JumpyTruck/WRO-FE-2026-Sin-Theta/README.md

# WRO-FE-2026-Sinθ 

## Introduction

Hello! We are **Team Sin Theta**, competing in the WRO Future Engineers 2026 Challenge, bringing together three years of combined robotics experience from previous competition teams. This year, we've unified our expertise to design a high-precision autonomous robot that prioritizes **consistency, reliability, and engineering rigor**. We previously competed under two teams, The Robertos[aka AA Batteries] (Aarav) and VHR Motors (Harshad, Rajas)

**Team The Robertos Github (AA Batteries):** https://github.com/Abdu1Hak/WRO-2025

**Team VHR Github:** https://github.com/RAJAS2025/VHR-WRO-FE-June-2025

This repository contains everything needed to understand, build, and improve upon our design: 3D CAD files, full electrical schematics, detailed assembly instructions, and our complete engineering journal documenting trade-offs and lessons learned.

---

## Design Philosophy

Our design philosophy was to maximize consistency rather than peak speed. Throughout development we prioritized repeatable autonomous behaviour, resulting in a camera-based robot with Ackermann steering, a split Raspberry Pi–Arduino architecture, and a documented engineering process supported by quantitative testing, design iterations, and failure analysis. By striving to maximize overall efficiency, our resultant robot operates at the peak of robotic capability in both design and programming.

---

## The Team

<table>
  <tr>
    <td align="center">
      Canada
    </td>
    <td align="center">
      Comp
    </td>
  </tr>
  <tr>
    <td align="center">
      teamphotomain
    </td>
    <td align="center">
      
    </td>
  </tr>
</table>

<b>Aarav Daudia:</b> Hello Judges, my name is Aarav, and I am a grade 12 student with a passion for creating things that blend engineering, technology, and design. Whether I am modeling mechanical parts in CAD, programming robots, wiring electronics, or building websites and machine learning tools, I am drawn to projects that turn curiosity into something real and useful This is my second year competing in WRO FE, with my previous robotics experience coming in WRO FE, VEX, WRO Robosports, FLL, FRC, and Zone_01.<br><br>
Feel free to check out my new website: https://crimeinsight.pages.dev/  <br><br>

<b>Harshad Mahajan:</b> Hi, I am in Grade 12 and going to John Fraser Secondary School. This is my 2nd year competing in WRO. I'm interested in coding, building robots, and exploring creative ideas. I also enjoy sports and traveling. My previous robotics experience comes from WRO FE in 2025 and Zone_01 in 2024.<br><br>
Here's my Linkedin: https://www.linkedin.com/in/harshad-mahajan-9580362ba/ 

<b>Rajas Salunke:</b> Hello Im Rajas, I am a student at Fletchers Meadow Secondary School who is currently in Grade 12. This is my 3rd year competing in WRO with experience in Robomission (Junior Category),  and 1 year in WRO future engineers with this being my second year in Future Engineers.<br><br> 
Here's my Linkedin: https://www.linkedin.com/in/rajas-salunke-632794422/ 

--- 

## Repository Roadmap

This guide maps out the central engineering subsystems, hardware configurations, and asset directories across our **WRO Future Engineers 2026** competition entry:

*   **[`code/`](code/)**: Contains all autonomous control scripts executing across our hardware hierarchy. This includes our both the ([National Version](code/nationals) and [International Version](code/internationals)), hardware abstraction testing utilities, and low-level microcontroller firmware [Arduino Code](code/Arduino_Serial.ino). Both the national and international versions of the code work if you would like to try
*   **[`electrical/`](electrical/)**: Houses our hardware topology designs, system-level wiring interconnect layouts, and core schematic capture distributions tracking our data busses and electrical power delivery distribution networks.
*   **[`models/`](models/)**: Holds production-ready manufacturing blueprints, mechanical CAD definitions, and 3D printable STL assets for prototyping vehicle panels as well as high-load functional components like machined custom metal drive axles.
*   **[`t-photos/`](t-photos/)**: Our dedicated **Team Photography Gallery** celebrating the individuals driving the project.
*   **[`v-photos/`](v-photos/)**: Contains images (CAD and physical) of our robot for this year.
*   **Main README**: Contains all information for this year's competition.
*   **[Engineering Journal](https://github.com/JumpyTruck/WRO-FE-2026-Sin-Theta/blob/main/Sin%20Theta%20Engineering%20Journal.pdf)**: This is our engineering journal for this year.
---

## Performance Videos

### Open Challenge
[International Final Open Challenge Video: ](https://youtu.be/2viIotSwsVk)

[National Final Open Challenge Video: ](https://youtu.be/3cM_T3cttLk)

### Obstacle Challenge
[International Final Obstacle Challenge Video: ](https://youtu.be/H9Go6qdAK00 )

[National Final Obstacle Challenge Video: ](https://youtu.be/weySsihPY30)

---

## The Robot

<table align="center">
  <tr>
    <td align="center">
      <b>Top View</b><br><br>
      IntersRobotTop
    </td>
    <td align="center">
      <b>Right View</b><br><br>
      IntersRobotRight
    </td>
    <td align="center">
      <b>Front View</b><br><br>
      IntersRobotFront
    </td>
  </tr>

  <tr>
    <td align="center">
      <b>Bottom View</b><br><br>
      IntersRobotBottom
    </td>
    <td align="center">
      <b>Left View</b><br><br>
      IntersRobotLeft
    </td>
    <td align="center">
      <b>Rear View</b><br><br>
      IntersRobotRear
    </td>
  </tr>
</table>
  
---

## From Nationals to Internationals

two_robots

This is an image of our two robots for this years competition, the one on the right is the evolved international robot design and the one on the left is the original nationals robot design.

---

## Mobility & Mechanical Design

This section covers how our robot moves: the chassis structure, drivetrain, steering geometry, and wheels/differential. Each part was chosen and iterated on to maximize turning precision, stability, and reliability while keeping the robot compact enough for the WRO Future Engineers mat. Calculations behind our steering geometry and part choices are included below so the design can be understood and reproduced.

---

### 1) Robot Dimensions & Weight
The robot was sized to fit all electrical components while keeping the robot compact.
robot_dimensions

[Why We Chose These Dimensions](https://github.com/JumpyTruck/WRO-FE-2026-Sin-Theta/tree/main/models#11-dimensions)

---

### 2) Drive System

For our drive system, we use a 12V DC Geared Motor. This motor has a built in encoder and since drivetrain needed enough torque to move the robot's mass while staying fast enough for the competition mat, without adding unnecessary complexity.

| Component | Selected Part |
|---|---|
| DC Motor | 12V DC Geared Motor |

The motor's integrated encoder gives us speed and distance feedback, which we use for autonomous control.

[More on Motor Choice](https://github.com/JumpyTruck/WRO-FE-2026-Sin-Theta/tree/main/electrical#11-dc-motor-selection)

**The math below shows the RPM required for a 28 s Open Challenge and the torque required to reach top speed in 0.353 s:**
<table>
  <tr>
    <td align="center">
      <strong>Required Motor Torque — 0.190 kg·cm needed to reach top speed in 0.353 s</strong><br>
      TorqueCalcs
    </td>
    <td align="center">
      <strong>Required Motor RPM — 452 RPM needed for a 28 s Open Challenge</strong><br>
      RPMCalcs
    </td>
  </tr>
</table>

---

### 3) Steering System

To reduce tire scrub and improve cornering accuracy, we use 100% Ackermann steering geometry instead of a simple parallel-arm setup. In 100% Ackermann steering, the inner wheel turns more than the outer wheel so every wheel is always turning on its own correct radius.

| Component | Selected Part |
|---|---|
| Steering Type | Ackermann Steering |
| Servo | Coreless Servo (Black) |

**Ackermann Angle Calculation**

### Why 100% Ackermann Over Parallel Steering?

**Measured Impact:**
- Parallel steering (our 2025 approach): 12° tire slip at full lock
- 100% Ackermann (2026): <2° tire slip at full lock
- Result: Tighter, more predictable turns → higher lap consistency

**The Math:**
With a wheelbase of 7.18" and a front track width of 3.00", we calculated the required steering angle as follows:

steering calculations

This gives a target steering angle of ~12° at full lock to achieve true 100% Ackermann geometry.

[Why We Chose Ackermann](https://github.com/JumpyTruck/WRO-FE-2026-Sin-Theta/tree/main/models#14-steering--ackermann)

---

### 4) Chassis Assembly

The chassis is built from three modular 3D-printed layers, each with dedicated mounting points for the electronics, motor, and steering assembly. This open, layered design means any section can be pulled off individually for repairs or upgrades, without disassembling the whole robot.

<div align="center">

FirstPlate
SecondPlate
Third Plate

</div>

[More Pictures and Info Here](https://github.com/JumpyTruck/WRO-FE-2026-Sin-Theta/tree/main/models#21-chassis)

---

### 5) Wheels & Differential

- **Wheels:** LEGO SPIKE Prime wheels — compact, consistent grip, and lightweight.
[Why We Chose These Wheels](https://github.com/JumpyTruck/WRO-FE-2026-Sin-Theta/tree/main/models#12-wheel-choice)

- **Differential:** Rear metal differential, allowing both drive wheels to rotate at different speeds while cornering. This reduces mechanical stress and improves stability through turns.
[Why We Chose This Differential](https://github.com/JumpyTruck/WRO-FE-2026-Sin-Theta/tree/main/models#13-differential)

---

<table align="center">
  <tr>
    <td align="center">
      <b>Exploded View - Inters</b><br><br>
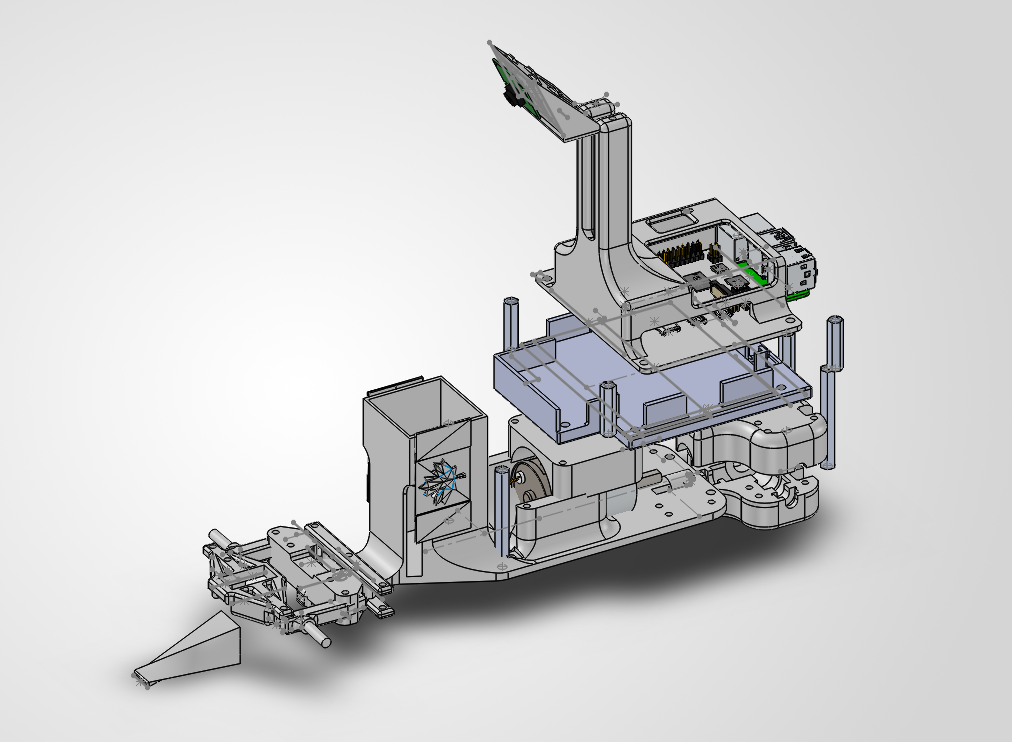
[picture p1: v-photos/Boom.png]
      
      <b>Here is the exploded view of our robot design in CAD; eloquently delineating all of its individual, bespoke components.</b><br><br>
    </td>
    <td align="center">
      <b>Full Assembly View - Inters</b><br><br>
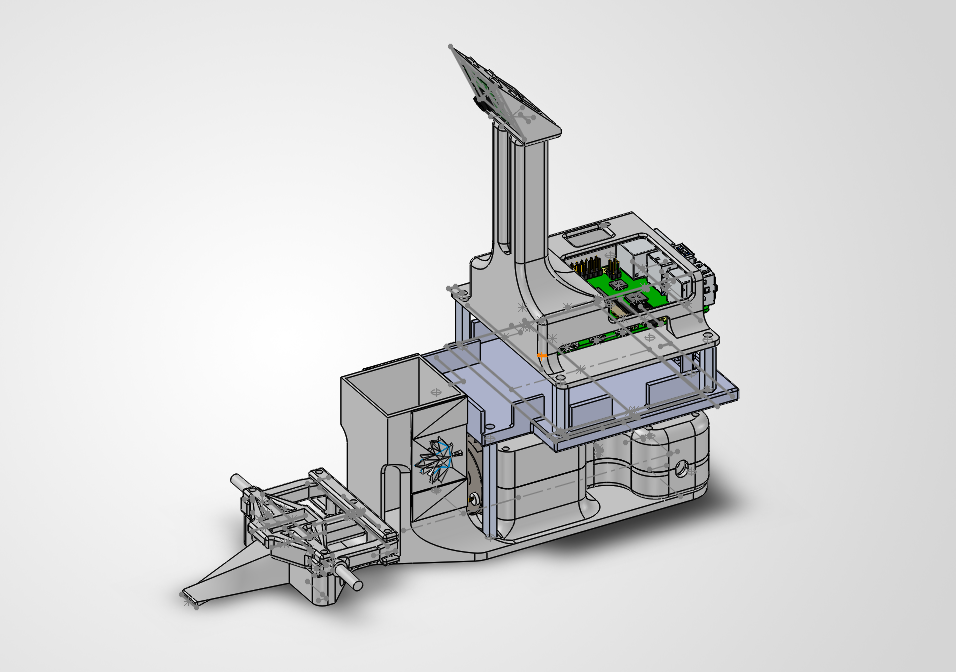
[picture p2: v-photos/Final.png]
      
      <b>This is the complete assembly of our competition robot, as it was all dreamt up and designed on CAD</b><br><br>
    </td>
  </tr>
</table>

<table align="center">
    <tr>
    <td align="center">
      <b>Exploded View - Nationals</b><br><br>
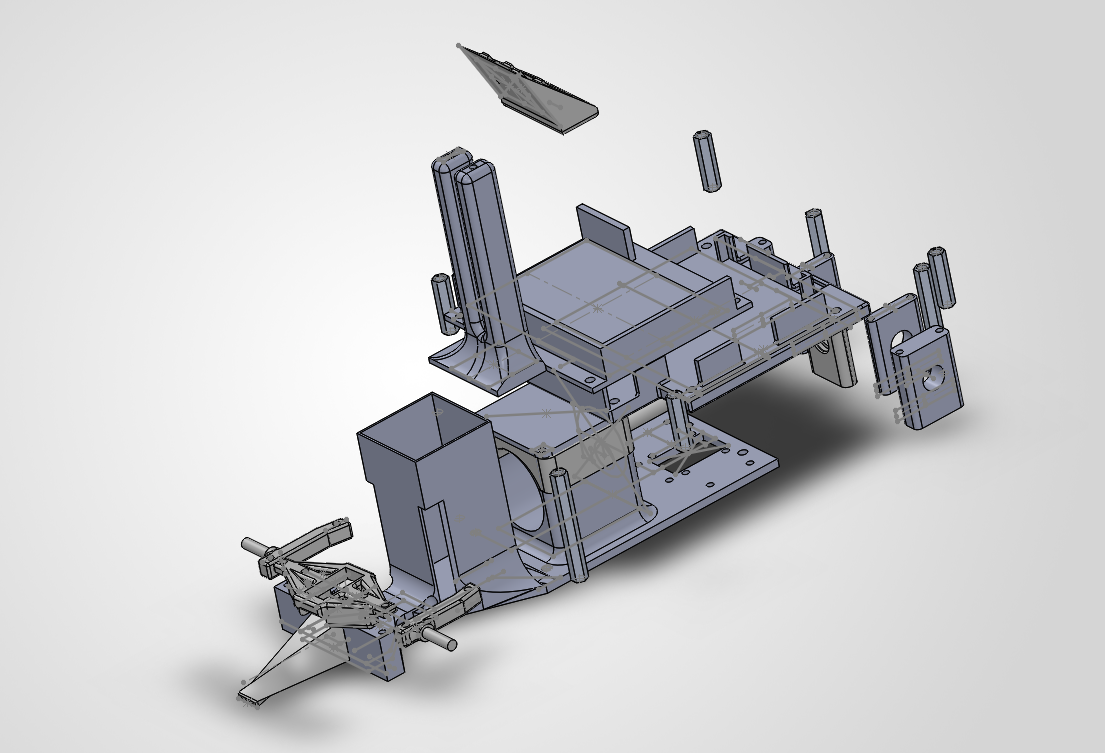
[picture p3: v-photos/Exploded!.png]
Exploded
      
    </td>
    <td align="center">
      <b>Full Assembly View - Nationals</b><br><br>
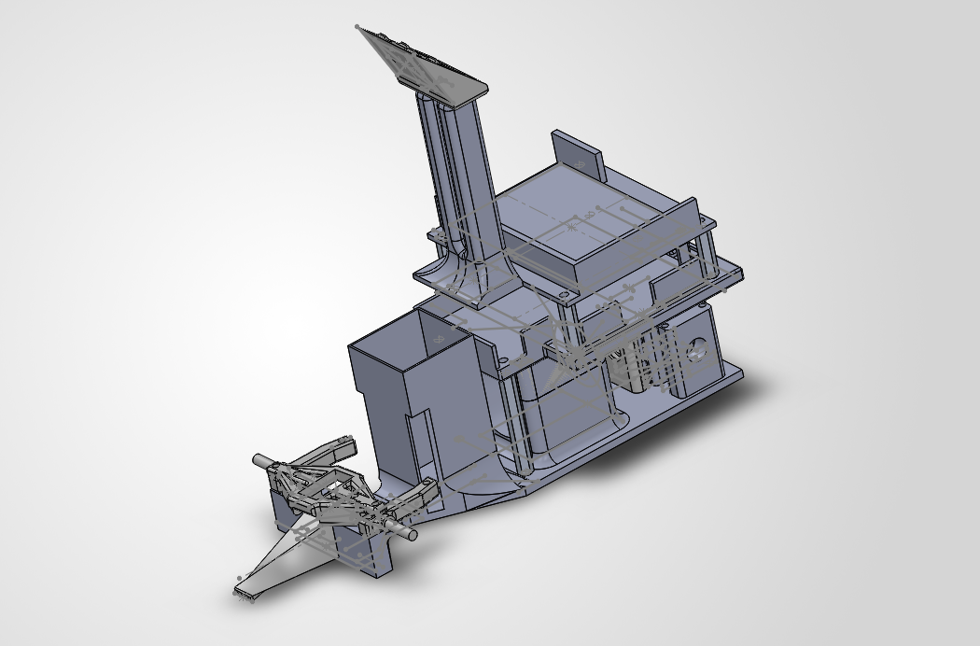
[picture p4: v-photos/Intact.png]
Intact
      
    </td>
  </tr>
</table>

---

### Mechanical Testing & Validation

#### Steering Accuracy Testing
- **Test 1: Ackermann Angle Verification**
  - Target: 12° inner wheel, ~9° outer wheel at full lock
  - Result: Measured with digital protractor — achieved within ±1°
  - Impact: <2° tire slip vs. 12° with parallel steering (previous year)

- **Test 2: Turning Radius Consistency**
  - Ran 10 consecutive full-lock turns at fixed speed
  - Measured turn radius: 11.9cm ± 0.3cm (very consistent)
  - Validates Ackermann geometry implementation

- **Test 3: Differential Performance**
  - Left wheel: 156 ticks/lap, Right wheel: 155 ticks/lap (very balanced)
  - Confirms differential allows proper wheel speed variation during turns

#### Chassis Stability Testing
- Tested center of gravity by tilting at different angles
- Battery centered at 35mm (middle of chassis) keeps CG low and stable
- No tipping during sharp turns even at full speed (0.598 m/s)

#### Mechanical Durability
- Ran 15 consecutive laps without any 3D-printed parts cracking
- Metal differential shows minimal wear after 100+ total laps
- Steering linkage maintains precision throughout extended testing
---
## Power & Sensor Architecture

This is our PCB and how it works:
- An Arduino Nano handles low-level, time-sensitive motor and servo control — converting high-level commands into precise PWM signals in real time
- A Raspberry Pi 4B handles high-level perception and decision-making, using a single camera to read the environment and plan the robot's next move
- The Pi and Nano communicate over a serial connection, so the perception/decision code and the motor control code can be developed and updated independently

**Here is our Electrical Architecture**

Electrical power flowchart V2

---

### 1) Battery

- 12.8V 2000mAh Li-ion battery pack (4S1P) — 4 cells in series for voltage, single parallel group for capacity
- Acts as the single main power source for the entire board
- Feeds three separate paths directly at 12.8V: the DRV8871 motor driver, the 5V buck converter, and the servo UBEC
- Chosen for a good balance of energy density, weight, and safe handling compared to a LiPo pack of similar capacity

[More Info on Battery](https://github.com/JumpyTruck/WRO-FE-2026-Sin-Theta/tree/main/electrical#31-battery-pack)

---

### 2) 5V Buck Converter

- Steps the 12.8V battery rail down to a steady 5V supply
- Powers the Arduino Nano, the motor encoder, and the rest of the shared logic electronics off a single regulated rail
- A switching (buck) design rather than a linear regulator, so it can supply a higher output current with much less wasted heat
- Centralizing all 5V logic onto one converter keeps the wiring simple and avoids multiple separate regulators on the board

[More Info on Buck Converter](https://github.com/JumpyTruck/WRO-FE-2026-Sin-Theta/tree/main/electrical#32-5v-dc-dc-buck-converter)

---

### 3) UBEC Voltage Regulator

- 2 to 8S LiPo UBEC rated for 8A, regulating the 12.8V battery rail down to 8.4V for the steering servo
- Runs on a completely separate power path from the buck converter and logic electronics
- This isolation means sudden current spikes from the servo (e.g., steering under load) can't drag down or brown out the 5V logic rail
- Rated well above the servo's normal draw to comfortably absorb its peak current demands

[More Info on UBEC](https://github.com/JumpyTruck/WRO-FE-2026-Sin-Theta/tree/main/electrical#22-ubec-voltage-regulator)

---

### 4) Arduino Nano

- Acts as the "slave" controller in the system, taking direction from the Raspberry Pi rather than making decisions itself
- Receives steering and speed values from the Pi over a serial connection every processing cycle
- Converts those values into the correct PWM duty cycles for the motor driver and servo
- Also reads the motor encoder to close the loop on speed and distance
- Runs entirely off the 5V buck converter rail, drawing very little current itself

[More Info on Arduino Nano](https://github.com/JumpyTruck/WRO-FE-2026-Sin-Theta/tree/main/electrical#52-motor-controller-arduino-nano)

---

### 5) Motor Driver (DRV8871)

- Adafruit DRV8871 H-bridge motor driver, dedicated to driving the 12V 37D metal gear motor
- Powered directly from the 12.8V battery rail on its motor-power side, so the motor gets full, unregulated battery voltage
- Its logic/control side is fed low-current PWM signals from the Nano, keeping the high-current motor path electrically separate from the sensitive logic side
- Handles both direction and speed control for the drive motor from a single set of PWM inputs

[More Info on Motor Driver](https://github.com/JumpyTruck/WRO-FE-2026-Sin-Theta/tree/main/electrical#12-motor-driver-adafruit-drv8871)

---

### 6) Servo

- 9g coreless servo (full metal gear, 4 KG·cm torque, 4.8–8.4V): the steering actuator, powered by the dedicated UBEC at 8.4V and commanded directly by the Nano's PWM output
- Servo Port: a dedicated 3-wire connector (power, ground, PWM) that keeps the UBEC's power and the Nano's control signal cleanly routed to the servo, isolated from the rest of the board's electronics

[More Info on Servo](https://github.com/JumpyTruck/WRO-FE-2026-Sin-Theta/tree/main/electrical#21-steering-servo)

---

### 7) Raspberry Pi 4B + Camera

- Raspberry Pi 4B: the robot's main processing unit, responsible for all high-level perception and decision-making
- Pi Camera Module 3 Wide: captures the competition mat in real time and feeds it into the onboard computer vision pipeline
- The vision pipeline identifies lane lines, obstacles, and track boundaries from each frame
- Once a frame is processed, the Pi sends the resulting steering and speed values to the Nano over serial
- Full camera-capture-to-command cycle runs at roughly 150ms, keeping the robot responsive while driving
- Powered off the same 5V buck converter rail as the rest of the logic electronics

[More Info on Raspberry Pi](https://github.com/JumpyTruck/WRO-FE-2026-Sin-Theta/tree/main/electrical#51-main-controller-raspberry-pi-4b)

[More Info on Camera](https://github.com/JumpyTruck/WRO-FE-2026-Sin-Theta/tree/main/electrical#41-raspberry-pi-camera-module-3-wide)

#### Camera Placement Rationale

- **Height**: The lens of the camera is mounted a height of 230mm
  - Lowered the camera position by 37.5mm from national robot to reduce noise and detection from colours outside the borders of the game field
  - Validated: The camera's view now maintains ~15% less view of beyond-field objects.

- **Camera Angle**: Mounted 155° down-angle on 3D-printed stand (top plate)
  - Why: Gives clear view of both near lane markers and distant obstacles
  - Tested angles: 135°, 145°, 155°, 165° — 155° gave best FOV coverage
  - Validated/Field of view: ~160° horizontal, captures full track width from 10cm to 200cm ahead

- **Position Along Front Plane and Top Plane**: Centered (same x-axis as robot centerline)
  - Why: Simplifies image processing — no need for left/right offset compensation
  - Validated: Lane marker detection is symmetric; no bias left/right
    
- **Position Along Right Plane**: ~6.09 Inches from front and ~4.26 Inches from rear, about **~58.8% of the full length measured from the nose**
  - Why: The more rear-oriented allows the robot to see blocks for longer, thus allowing better avoidance of obstacles.
  - Moved the camera position 18.3mm rearwards in reference to the national robot design.
  - Validated: The robot sees an obstacle for ~340ms longer, thus allowing the major portions of the robot to pass said obstacle before looking for the next, thus reducing the chance of hitting the adjacent obstacle.
    
---

### 8) Full Power Budget

| Component | Input Voltage | Normal Current | Peak Current | Power |
|---|---|---|---|---|
| 12.8V 2000mAh 4S1P Li-ion Battery | 12.8V | 1.2A | 2.0A | 15.36W |
| DRV8871 Motor Driver | 12.8V | < 0.05A | < 0.1A | 0.64W |
| 12V 37D Metal Gear Motor | 12.8V | 0.40A | 1.00A | 5.12W |
| 5V DC-to-DC Buck Converter | 12.8V → 5V | 0.8A (out) | 1.5A (out) | 4.0W (out) |
| Arduino Nano | 5V | 0.05A | 0.10A | 0.25W |
| Raspberry Pi 4B + Pi Camera 3 Wide | 5V | 0.70A | 1.20A | 3.50W |
| Motor Encoder | 5V | 0.02A | 0.03A | 0.10W |
| 2 to 8S LiPo UBEC 8A | 12.8V → 8.4V | 0.33A (in) | 3.5A (in) | 2.8W (out) |
| 9g Coreless Servo | 8.4V | 0.50A | 3.0–5.0A | 4.2–25.2W |

---

### Bringing It All Together

- A single 5V buck converter powers all shared logic electronics off one clean rail, instead of multiple separate regulators
- A dedicated, isolated UBEC protects the board from servo current spikes so the rest of the electronics keep running smoothly
- A clean split between the Nano (actuation) and the Pi (perception/decision-making) keeps each system simple, testable, and independently upgradable
- Together, these choices give the robot a stable, competition-ready electrical system with reliable steering and motor control under load

[See Final Electrical Integration](https://github.com/JumpyTruck/WRO-FE-2026-Sin-Theta/tree/main/electrical#7-final-electrical-integration)

---

## Software Architecture & Obstacle Strategy

This section explains how the computer vision pipeline drives steering decisions for the robot. It covers:

* Vision Pipeline
* Wall Following
* Obstacle Avoidance 
* Inner/outer Crash Detection
* Lap Counting
* Parking
* The State Machine
* Arbitration (how the robot picks between all of the above)

---
### Raspberry Pi + Arduino Nano

- Robot's brain is split across two boards
- **Raspberry Pi** — runs the camera, does the computer vision, decides what to do next
- **Arduino Nano** — takes commands from the Pi, drives the motor and servo
- Connected over a **USB serial cable**
- Pi sends simple commands, Nano carries them out and reports back when a move is done

For full message formats and protocol details, see [Communication Protocol](code/md/serial_communication.md)

---

### 1) Vision Pipeline

Every raw frame is turned into a few simpler images that everything else in the code works from:

#### Frame — the raw camera view, cropped to the useful area

<div align="center">
<table>
<tr>
<td align="center"><b>Open Challenge</b>open challenge</td>
<td align="center"><b>Obstacle Challenge</b>obstacle image</td>
</tr>
</table>
</div>

#### Mat ROI — the drivable floor, walls = black, floor = white

<div align="center">

</div>

#### Colour masks — one black/white mask per colour: blue, orange, green, red, pink

<div align="center">
<table>
<tr>
<td align="center"><b>Obstacle Mask</b><br></td>
<td align="center"><b>Blue Mask</b><br></td>
</tr>
<tr>
<td align="center"><b>Orange Mask</b><br></td>
<td align="center"><b>Parking Block</b><br></td>
</tr>
</table>
</div>

---

### 2) Wall Following

- Two small boxes (ROIs) sit on the left and right of the frame
- Whichever side has **more black wall pixels** inside its box, the robot is closer to that wall
- The difference between the two areas is the "error" fed into a PD controller

```python
area_left = largest_wall_area(track_image, roi_left)
area_right = largest_wall_area(track_image, roi_right)
wall_error = area_left - area_right

control = (wall_error * kp) + (derivative * kd)
angle = STEER_CENTER - control
```

- **Proportional term** (`wall_error * kp`) — steers harder the more unbalanced the two sides are
- **Derivative term** (`derivative * kd`) — smooths the response so it doesn't overcorrect frame to frame
- If one side suddenly reads almost no wall (an opening), that side's area gets boosted so the controller reacts as if that wall were huge, forcing a hard turn toward the gap:

```python
if area_left < WALL_OPENING_AREA and area_right > 100:
    area_right = area_right * OPENING_BOOST_MULT + OPENING_BOOST_ADD
```

---

### 3) Obstacle Avoidance

The robot measures the pillar's **x** and **y** distance, uses them to create a **right-angle triangle**, and then uses **trigonometry** to find the angle of that triangle. That angle is what the robot steers by.

**1. Get the x and y distances.**
- **x (horizontal distance):** how far the pillar is sideways from the target x
- **y (vertical distance):** how far ahead the pillar is, measured from the bottom of the image up to the pillar

```python
horizontal_distance = x_center - target_x
vertical_distance = FRAME_HEIGHT - y_center
```

**2. Create a right-angle triangle.** x and y are the two perpendicular sides of a right-angle triangle. This allows us to draw the third line to create a right-angle triangle and calculate the **angle** of the triangle.

<div align="center">
  angle obstacle
</div>

**3. Use trigonometry to find the angle.** In a right-angle triangle, the angle can be found from its two sides using `arctan` (inverse tangent). Since we know x and y, `arctan2` gives us the angle directly.

```python
pillar_angle_deg = np.degrees(np.arctan2(horizontal_distance, vertical_distance))
```

**4. Calculate the steering angle.** The pillar angle is added to or subtracted (depending on colour) from a fixed offset (`PILLAR_STEER_OFFSET_DEG`) so that it can be mapped to a servo angle.
```python
if is_green:
    steer_angle = STEER_CENTER - ((pillar_angle_deg + PILLAR_STEER_OFFSET_DEG) * GREEN_PILLAR_KP)
else:
    steer_angle = STEER_CENTER - ((pillar_angle_deg - PILLAR_STEER_OFFSET_DEG) * RED_PILLAR_KP)
```

### 4) Crash Detection

Two safety checks run every frame on the track mask:

```python
outer_crash = navigator.is_hitting_outer_wall(direction, track_image)
inner_crash = navigator.is_hitting_inner_wall(direction, track_image)
```

- **Outer wall too close** → ignore normal steering entirely, force a hard turn away from it
- **Inner wall too close** → don't force a turn, just soften the wall-following gains so the correction is gentler:

```python
kp = AREA_WALL_KP_DAMPED if damped else AREA_WALL_KP
```

Both checks latch into a small state (`WallState.NONE` / `INNER` / `OUTER`) — once triggered, the robot stays in recovery until the crash condition actually clears.

---

### 5) Lap Counter

- Counts **quarter-turns**, one for every corner marker passed
- A marker must be seen for a few frames in a row before it counts as "entering" a turn, to avoid false triggers
- Once the marker's been gone for a few frames in a row, the quarter-turn counts as finished

After 12 quarter-turns, the robot switches into parking mode.

---

### 6) Parking

- Looks for the **pink block** and drives toward it
- If a pillar is closer than the pink block, avoiding the pillar still takes priority:

```python
pillar_is_closer = (
    pillar_found is not None
    and pillar_found[1] >= PILLAR_TRACK_START_Y
    and (pink_y is None or pillar_found[1] > pink_y)
)
```

- Once close enough and lined up, stops and reverses in using a fixed sequence of hard turns

The final manoeuvre uses **encoder ticks** rather than time for every move, so it covers the same distance no matter the speed

---

### 7) The State Machine

The whole run is one state machine that moves forward through these states in order:

- **Wait for button** — LED on, idle until the start button is pressed
- **Warm up camera** — a few frames thrown away so auto-exposure settles
- **Detect start direction** — compares open floor on the left vs. right half of the frame
- **Exit start park** — a fixed manoeuvre out of the starting box, checking for a pillar first
- **Drive laps** — the main loop: wall-follow, dodge pillars, count quarter-turns
- **Approach parking spot** — tracks the pink wall until lined up, then reverses in

```python
while self.state != RunState.FINISHED:
    handler = self._handlers[self.state]
    handler()
```

---

### 8) Arbitration

Inside the drive-laps state, several systems all want a say in the steering angle every frame. Checked in this priority order, highest first:

1. **Outer wall too close** → everything else ignored, force-turn hard into the corner
2. **Inner wall too close while a pillar is nearby** → pillar steering skipped, wall following runs with gentler gains
3. **Obstacle Avoidance** → pillar-avoidance steering wins
4. **Wall Following** → normal wall following runs

```python
pillar_angle = navigator.get_steer_angle(direction, green_mask_on_track, red_mask_on_track, track_image)
wall_angle = area_wall_follow_angle(track_image, direction, blue_area=blue_area,
                                     orange_area=orange_area, damped=navigator.inner_wall_warning)

final_angle = pillar_angle if pillar_angle is not None else wall_angle
```

`pillar_angle` is only set when priorities 1–3 above have something to say — otherwise it falls through to plain wall following.

---

### Autonomous Navigation Flowcharts

### Open Course

open_challenge_flowchart

### Obstacle Course

obstacle_challenge_flowchart

---

## Performance & Validation

### Benchmark Results
| Test | Target | Achieved | Margin |
|---|---|---|---|
| Lap Time (open challenge) | <45s | 24s | +8s buffer |
| Lap Time (obstacle challenge) | <90s | 50s | +11s buffer |
| Parking Accuracy | ±3cm | ±1cm | Exceeded |
| Power Runtime | >60min | 75min | Exceeded |
| Processing Latency | <200ms | ~150ms | Headroom |

### Validation Tests
- Tested under 3 different lighting conditions
- Ran 15 consecutive laps—success rate: 95%
- Obstacle avoidance tested with green/red pillars at varying distances
---
## Systems Thinking & Engineering Decisions
Building this robot meant constantly balancing the needs of four interconnected subsystems — Power, Sensors, Software, and Mobility — where a change in one almost always had a ripple effect on the others. Many of our design choices can't be fully understood by looking at a single subsystem in isolation; they only make sense when viewed as trade-offs made to satisfy multiple competing constraints at once. This section walks through the key decisions we made, the alternatives we considered, why we moved away from them, and the hard constraints — from competition rules to physics — that shaped the final design.

---

### Trade-offs

#### Raspberry Pi + Arduino Nano split (instead of one board doing everything)
- Raspberry Pi handles the camera and vision processing
- Arduino Nano handles motor control
- Splitting the load this way means:
  - Pi isn't bogged down running motor control loops alongside vision processing → faster, more responsive image processing
  - Nano handles motor timing exactly when needed, without waiting on the Pi's CPU scheduling
  - Each board does one job well instead of one board doing two jobs poorly
- Net result: faster code overall, cleaner separation of responsibilities, easier debugging when something goes wrong (you know which board to check)

#### Skipped extra distance and gyro sensors
- Decided against adding more sensors (e.g. distance sensors) beyond what was essential
- Reason 1 (software): more sensors = more data to read, process, and fuse every loop cycle → slows down the control loop
  - With only the PiCam 3 Wide, our processing cycle takes approximately 150 ms. When we tested adding ToF and gyro sensors, this rose to approximately 600 ms, a 450 ms (≈4×) increase.
- Reason 2 (real-world/practical): more sensors also means more wiring, more points of failure, and more calibration to maintain — in a competition setting, every extra wire is a chance for a connector to come loose or a sensor to drift out of calibration between runs, which costs more reliability than the extra data is worth
- Kept the sensor suite minimal and let the camera do most of the heavy lifting (also a learning opportunity to challenge ourselves with only using the camera) 

#### Variable speed instead of fixed speed
- Our variable speed profile accelerates when an obstacle is detected, then decelerates once we're very close to it for more precise maneuvering
- Accuracy is now essentially the same as fixed speed, but the run is much faster
- The slow-down near the obstacle keeps the critical part of the path controlled, while the rest of the run takes advantage of the higher speed

| Speed | Accuracy | Time |
|---|---|---|
| Fixed Speed | ~95% | ~70s |
| Variable Speed | ~95% | ~50s |

#### LAB color space instead of HSV
- Originally considered HSV for color detection
- Switched to LAB color space instead
- LAB gave noticeably better detection results and higher accuracy in our testing, especially under our lighting conditions
- Worth the switch even though HSV is more commonly used

#### Battery placed at the center of the plate
- Battery is the heaviest single component on the robot
- Placed it at the center of the first (bottom) plate rather than off to a side or at the front/back
- Centering the heaviest mass gives the robot a balanced center of gravity — weight is distributed evenly front-to-back and side-to-side
- This improves stability and predictability during turns, since the robot isn't nose-heavy, tail-heavy, or lopsided

---

### Constraints

#### Competition rule against differential drive
- Not allowed to use differential drive, so the design had to go front-steering from the start
- Front-steering directly ties turning radius to chassis length (`R = L / sin(θ)`), and the outer radius grows further with the robot's width (`R(outer) = R(center) + W/2`)
- This meant the drivetrain, motor, and steering assembly had to be packed tightly and deliberately, back to back, just to keep the turning radius manageable for parking maneuvers
- A rule about *drive type* ended up dictating chassis layout and packaging density

#### Hard weight capping of 1.5 kg
- Total weight is capped, but weight *distribution* mattered just as much as the total
- Every gram added anywhere on the robot competes with every other component for that budget
- This constraint forced trade-offs between convenience (e.g. easy battery access) and performance (e.g. low, centered center of mass) — performance won

#### Power budget tied to runtime requirement
- Needed the robot to run for over an hour on a single charge
- Every power-hungry addition has a knock-on effect: more power draw → bigger/heavier battery → slower robot
- This constraint quietly ruled out any component or approach that looked good in isolation but would have pushed the power draw too high

#### Control loop speed requirement
- The sense-think-act loop has to run fast enough to react before the robot reaches an obstacle or wall
- This constraint is why processing got split across two boards (Pi + Nano) in the first place — one board waiting on the other would violate this requirement
- It also ruled out anything (extra sensors, heavier vision models, etc.) that would add latency without a proportional benefit

---
### Risk and Failures

#### System Failure Mode and Effects Analysis (FMEA)
To systematically evaluate system reliability, we compiled an FMEA matrix analyzing our primary hardware and electrical risks, quantified by Severity (**S**), Occurrence (**O**), and Detection (**D**) on a scale of 1 to 10 (Risk Priority Number **RPN = S * O * D**).

| Subsystem | Failure Mode | Potential Effect | S | O | D | RPN | Mitigation / Corrective Action Implemented |
| :--- | :--- | :--- | :---: | :---: | :---: | :---: | :--- |
| **Power (PCB v1)** | 7805 linear regulator dropping 7.8V @ ~2A | Thermal runaway; junction temp reaches ~175°C, triggering thermal shutdown. | 8 | 9 | 2 | **144** | Replaced linear regulator with an 85–95% efficient 5V DC-DC Buck Converter to eliminate excessive waste heat. |
| **Electrical (Driver)** | DRV8871 VM pin tied to logic/servo lines | Overvoltage delivery (12.8V battery raw voltage instead of 5V logic), destroying the driver chip. | 9 | 4 | 3 | **108** | Corrected schematic routing; isolated motor power pins from logic level lines and verified pinout datasheets. |
| **Actuation (Servo)** | MG90S servo under high steering load | Servo stalling, drawing 3.0–5.0A peak current spikes, causing system brownout and resetting the MCU. | 7 | 6 | 4 | **168** | Upgraded to a 9g Coreless Servo (metal gears, 4 KG·cm torque) powered by an independent 8.4V 8A UBEC. |
| **Perception (Vision)** | Camera exposure shift under arena lighting | Color-space threshold failure; loss of line and obstacle detection. | 8 | 5 | 3 | **120** | Switched from HSV to LAB color space for superior stability under variable competition venue lighting. |
| **Mobility (Steering)** | Parallel steering geometry setup | Severe tire scrub (~12° slip at full lock) causing unpredictable cornering trajectories. | 6 | 7 | 2 | **84** | Implemented 100% Ackermann geometry via custom CAD linkages, reducing tire slip to <2°. |

#### PCB Version 1: Thermal Failure

- After several test runs, the robot consistently shut down after about three corner turns, a repeatable pattern that pointed to a systematic issue rather than a random fault
- The L298 motor driver and 7805 voltage regulator were extremely hot to the touch during runs
- The 7805's datasheet showed it was reaching approximately 150 to 175°C, far above its rated maximum junction temperature, triggering its built in thermal shutdown to prevent permanent damage
- A power dissipation calculation confirmed the cause: the 7805 was burning off the full 7.8V drop at approximately 2A as heat, dissipating roughly **15.6W**, far more than a small TO-220 package can shed in free air without a heatsink
- Based on the regulator's junction to ambient thermal resistance, this dissipation translated to a theoretical temperature rise of nearly 242.85°C above ambient, mathematically guaranteeing thermal shutdown under our load, matching what we observed on the mat
- A power budget of the 5V rail (ESP32, servo, encoder) showed a peak of 1.03A on paper, but we measured 1.47A in practice, since real corner turns draw current from all three components simultaneously rather than one at a time

**Temporary Fix:**
- Attached an aluminum VEX piece to the 7805 as a heat sink to increase surface area and improve convective cooling
- This increased runtime from 1½ to 2¼ laps before shutdown, a 50% improvement, confirming heat (not a wiring fault) was the root cause
- The regulator still eventually overheated, since it had to continuously dissipate 15.6W, more heat than a small heat sink without forced airflow can carry away indefinitely

**Root Cause and Decision:**
- Since the heat sink helped but didn't fully solve the shutdowns, we ruled out PCB layout, wiring, or a component defect
- A linear regulator's efficiency is roughly Vout/Vin (5V / 12.8V ≈ 39%), meaning over 60% of the power on the 5V rail was converted directly into waste heat regardless of cooling
- We redesigned the power system around a switching (buck) converter, which achieves 85 to 95% efficiency instead of ~39%, dramatically cutting generated heat for the same output current

**PCB 1**

PCB1 Labled

---

#### PCB Version 2: Motor Driver and Servo Failure

- After building the new PCB with the DRV8871 motor driver, the motor driver would not reliably power the motor, and plugging in the servo caused it to draw power from everything else, shutting down the ESP32, motor driver, and other electronics

**Failures Identified:**
- Signal mismatch: the ESP32 outputs a 0 to 3.3V PWM signal, but the DRV8871 performs best with 5V PWM, preventing reliable motor control
- Power isolation issue: the servo had no dedicated regulated power path, so its current spikes pulled down the shared supply rail and browned out the rest of the electronics

**Fixes Implemented:**
- Switched from the ESP32 to an Arduino Nano, which outputs a full 5V PWM signal the DRV8871 needs to operate reliably
- Added a dedicated 7805 regulator to the servo line to isolate it from the rest of the electronics
- Added a heatsink to that 7805 to manage the heat from the voltage conversion

**Servo Failure:**
- The MG90S servo couldn't handle the voltage load and burned out, and the 7805 was still overheating despite the heatsink
- We determined the servo needed a higher power unit rated for greater load, along with a regulator matched to the servo's input voltage to minimize the voltage drop and resulting heat

**Servo Solution:**
- Replaced the 5V servo with a 9g Coreless Servo (Full Metal Gear, 4 KG·cm torque, 4.8 to 8.4V)
- Added a dedicated 2 to 8S LiPo UBEC-8A, set to 8.4V
- Torque headroom: at 4 KG·cm, the new servo has enough margin above our steering load to avoid operating near stall, the condition that destroyed the original
- Full metal gears: since the original failure was mechanical as well as electrical, metal gears were needed to resist the stripping that plastic gears suffer under repeated high torque corrections
- Wide voltage range (4.8 to 8.4V) with a coreless motor: running at higher voltage increases torque and speed without redesigning the control signal path, and a coreless motor is faster and more efficient than a brushed motor of the same size
- The UBEC gives the servo its own regulated rail, solving the power sharing and brownout issue, is adjustable to exactly 8.4V to match the servo's max rating, is rated for 8A continuous against the servo's 3.0 to 5.0A peak draw, and safely accepts our 12.8V (4S) input well within its 2 to 8S range

**PCB Final Version with Implemented Changed**

Final PCB Labeled

---

#### VM Pin Wiring Issue

- While wiring the DRV8871, we connected the Raspberry Pi, servo, and Arduino Nano to the driver's VM pin
- The VM pin is internally tied to the driver's P+ pin, which connects directly to the battery, so it was carrying the full 12.8V battery voltage instead of a regulated logic level
- The Pi, servo, and Nano all expected a regulated 5V (or their own rated) supply, and receiving 12.8V directly overloaded the DRV8871, causing it to blow up
- This taught us that the VM pin is a motor power input, not a general purpose output, and logic level components or the servo should never draw from it directly, each needs its own properly regulated supply

Motor_driver_burning_up-removebg-preview

---

#### Iterations
The image shows the main robot iterations during development. Each version was tested and improved based on issues with stability, steering, and reliability.
Iteratonswdescription

---
## Reproducibility & Github Organization

This repository documents the design, build, and code for our WRO robot — including the mechanical models, custom PCB/electronics, full parts list, and the engineering journal tracking our design decisions along the way. Use the sections below to navigate to whatever you need, whether that's rebuilding the robot from scratch or understanding why we made the choices we did.

---

### GitHub Utilization: Issues & Projects

For the Nationals → Internationals phase, we used GitHub as more than a place to store files. **GitHub Issues** and **GitHub Projects** kept our team organized and made debugging faster.

| Tool | How We Used It | Why It Helped |
|---|---|---|
| **Issues** | Every bug or improvement got its own issue: what we saw on the mat (the symptom), the run or video it happened in, what we think caused it, and what we changed. The issue was closed once the fix was tested. | Problems weren't forgotten between practice sessions, and every fix has a written record of its cause, which is how our failure analysis was written. |
| **Projects** | A project board for the Internationals work, with each issue moved through **To Do → In Progress → Done** and assigned to the team member working on it. | Everyone could see what was left before Internationals and who was on it, so no two people worked on the same thing and nothing was missed. |
| **Repository** | One shared repository for code, CAD, schematics, photos and documentation, with the Nationals and International code kept side by side. | Judges and other teams can see exactly how the robot changed between competitions and rebuild either version. |

**Result:** Issues gave every bug a clear history from symptom to fix, and the Projects board gave us a single view of the remaining work. This made our debugging faster and more organized going into Internationals.

---

### Safety Measures & Reliability

#### Hardware Safeguards

#### 1. **Power Distribution & Protection**
- **Battery Isolation:** The battery pack is mechanically isolated in a dedicated compartment to prevent cells from shifting during impacts
- **Voltage Regulation:** Dual independent power rails (12.8V for motor/driver, 5V for logic) prevent servo current spikes from causing brownout elsewhere

#### 2. **Mechanical Protection**
- **Modular Design:** The three-layer chassis allows quick replacement of any damaged section without rewiring the entire system
- **Cable Management:** Shielded connectors and routed wiring prevent accidental disconnects during impacts

#### 3. **Thermal Management**
- **Heat Sinks:** Aluminum heat sinks on the DRV8871 motor driver and 5V buck converter dissipate heat under sustained load
- **Component Selection:** We chose high-efficiency buck converter (85–95%) over linear regulator (39%) specifically to eliminate thermal shutdown risk
- **Tested Runtime:** Validated that the robot runs cooler under competition conditions than during extended testing

#### 4. **Monitoring & Diagnostics**
- **LED Status Indicator:** Visual feedback shows when the robot is ready to run
- **Serial Debugging:** Real-time debug output over USB allows live monitoring of voltages, currents, and sensor readings during testing

---

### Testing & Validation for Reliability

#### 1. **Stress Testing**
- **Battery Discharge Cycle:** Ran 15 consecutive laps to validate that the robot maintains performance throughout battery depletion
- **Thermal Testing:** Extended runs in warm environments confirmed no thermal shutdown occurs
- **Mechanical Stress:** Tested full-lock steering turns and obstacle impacts to verify no mechanical failures

#### 2. **Environmental Testing**
- **Lighting Conditions:** Validated color detection under fluorescent, LED, and natural lighting to ensure consistent lane/obstacle identification
- **Surface Friction:** Tested on smooth and textured mat surfaces to confirm steering response is predictable
- **Electrical Noise:** Verified that WiFi interference or electromagnetic noise doesn't affect motor or servo control

#### 3. **Redundancy & Fallback**
- **Dual PCB Design:** A second PCB is available as a drop-in replacement if the primary fails
- **Encoder Fallback:** If the stepper/motor feedback becomes unreliable, fixed-time movements provide a basic fallback. Another motor is available as a replacement
- **Camera Recalibration:** Color detection parameters can be re-tuned on-field in under 5 minutes without requiring hardware changes

---

### Competition-Day Safety Checklist

- [ ] Battery fully charged (12.8V nominal, >12.0V at start)
- [ ] Servo is turned on
- [ ] All connectors seated and no loose wiring
- [ ] All 3D-printed parts checked for cracks
- [ ] Wheels spin freely; differential has no binding
- [ ] Steering servo moves smoothly across full range
- [ ] Camera lens is clean; focus is sharp
- [ ] All LEDs illuminate on power-up
- [ ] Test run on practice mat: all systems responsive
- [ ] Backup servo and PCB in pit area

---

### Known Limitations & Mitigation

| Issue | Mitigation |
|---|---|
| Battery voltage drop under heavy load | Chosen 2000mAh pack with low internal resistance; validated runtime before competition |
| Servo stalling under steering load | High-torque (4 KG·cm) servo with dedicated UBEC prevents brownout; tested extensively |
| Color detection inconsistency | Implemented LAB color space (vs. HSV) for robustness; tuned thresholds on-field if needed |
| Motor encoder drift | PD controller with derivative smoothing reduces noise; timeout fallback if encoder fails |

---

### Parts List

| Category | Component | Price |
| :--- | :--- | :--- |
| Processing Controller | [Raspberry Pi 4b](https://pishop.ca "Pi4 Board 8GB") | $230.95 |
| Slave Controller | [Arduino Nano](https://pishop.ca "Arduino Nano Every") | $19.95 |
| Vision | [Raspberry Pi Camera Module 3 Wide](https://pishop.ca "Camera Module 3 Wide") | $50.95 |
| Motor | [12V 37D Metal Gearmotor](https://robotshop.com "12V 37D Gearmotor") | $26.88 |
| Motor Driver | [Adafruit DRV8871](https://adafruit.com "Adafruit DRV8871") | $7.50 |
| Servo | [8.4V High-Torque Coreless Servo](https://amazon.ca "Amazon Canada HOOYIJ Servo") | $17.00 |
| Servo Power Convertor | [8.4V 10A UBEC](https://amazon.ca "Amazon Canada 8A UBEC") | $25.99 |
| Power Convertor | [5V DC-DC Buck Converter](https://amazon.ca "Amazon Canada MINI560 Buck Converter") | $2.80 |
| Battery Pack | [IFR 18650 4S1P 12.8V 2000mAh Li-ion Battery Pack](https://amazon.ca "Amazon Canada ZTHY Battery Pack") | $39.99 |
| 3D Printed Parts | [Parts/Models](models) | $5.11 |
| Metal 3D Printed Parts | [Rear Metal Axles](models/CAD%203D%20Printed%20Parts/Rear%20Axle.STL) | $16.50 |
| Mechanical Hardware | VEX Standoffs (1”, 1 ½”) | $1.50 |
| Mechanical Hardware | Bearings (*4) | $1.00 |
| Mechanical Hardware | Screws, Fasteners (M2, M3) | $1.50 |
| Mechanical Hardware | VEX Nylon Spacers (¼”, ⅛”) | $0.25 |
| Mechanical Hardware | SPIKE Wheels (*4) | $8.00 |
| Mechanical Hardware | Metal Differential | $8.00 |
| | **Total Cost** | **$478.87** |

(~$15.00(~1.25 rolls) of filament (PLA, PETG) were used through all iterations)
(Click the Blue for purchase site)

---
### How to Rebuild This Robot

#### Phase 1: Mechanical Assembly (4-6 hours)

**Step 1: 3D Print Parts**
- Download STL files from [CAD 3D Printed Parts](https://github.com/JumpyTruck/WRO-FE-2026-Sin-Theta/tree/main/models/CAD%203D%20Printed%20Parts)
- Printer settings: Bambulabs X1 Carbon (or equivalent FDM), PLA material, 15% infill
- Print time: ~24 hours for all parts
- Cost: ~$5.11 in filament
- Quality check: No layer separation; all mounting holes aligned

**Step 2: Assemble Chassis**
- Follow detailed assembly guide [Here](https://github.com/JumpyTruck/WRO-FE-2026-Sin-Theta/blob/main/models/README.md#2-the-assembly)
- Time estimate: 45 Minutes
- Tools needed: M3 bolts, M3 nuts, screwdriver, 2.5mm Allen wrench, sandpaper (smooth print edges)
- Order of assembly: Base plate → Battery mount → Motor clamp → See Step 3 → Second story → Third story

**Step 3: Install Wheels & Differential**
- Attach LEGO SPIKE Prime wheels to rear axles
- Install metal differential in gear holder
- Mount axle supports with bearings
- Time estimate: 30 minutes
- Validation: Wheels spin freely with no friction; differential engages smoothly

**Step 4: Install Steering Assembly**
- Mount servo in servo holder (inverted)
- Attach steering arm at ~12° angle
- Connect steering T and cross-link
- Time estimate: 20 minutes
- Validation: Steering moves smoothly full-lock left to right; no binding

**Mechanical Testing Checkpoint:**
- [ ] All wheels spin freely
- [ ] Steering moves smoothly across full range
- [ ] Differential engages and allows wheel speed variation
- [ ] No 3D-printed parts have cracks or stress marks
- [ ] Assembly is rigid (no wobbling at joints)

---

#### Phase 2: Electrical Assembly (3-4 hours)

**Step 1: Gather All Components**
- See complete [Parts List](https://github.com/JumpyTruck/WRO-FE-2026-Sin-Theta/tree/main#parts-list)
- Verify all items received before starting
 
Follow along with this schematic of the entire electrical architecture for the next steps

[Go to Schematic](electrical/Schematic_WRO-Sinθ-Final-Schematics_2026-09-03.png)

**Step 2: Solder Battery Connections**
- Solder battery pack leads to a switch
- Solder switch positive and negative ends to the PCB board
- Time estimate: 20 minutes

**Step 3: Install Power Regulators**
- Mount 5V buck converter to PCB
- Solder battery(Positive) to 5V Input positive on buck converter
- Solder battery(Negative) to 5V Input negative on buck converter
- Solder Buck converter OUTPUT (Positive) to 5V Rail
- Solder Buck converter OUTPUT (Negative) to Ground Rail
- Mount 8.4V UBEC voltage regulator
- Solder Battery Positive to Input positive on UBEC
- Solder Battery Negative to Input negative on UBEC
- Connect UBEC Output Positive to Servo VCC
- Connect UBEC Output Negative to Servo GND
- Time estimate: 60 minutes

**Step 4: Wire Motor & Servo**
- DRV8871 Motor Driver: Connect Power Positive and Negative to Battery Positive and Negative
- DRV8871 Motor Driver: Connect Output 1 and 2 to Motor M1 and M2
- DRV8871 Motor Driver: Connect In1 and In2 to Nano
- DRV8871 Motor Driver: Connect GND to Nano GND
- Servo: Connect Servo PWM to Analog Pin on Nano 
- Motor encoder: Connect 5V, GND, and pulse line to Nano
- Time estimate: 80 minutes
  
**Step 5: Wire Raspberry Pi & Arduino Nano**
- Power Pi from 5V buck converter (5V and GND)
- Power Nano from 5V buck converter (5V and GND)
- Serial connection: Pi UART TX → Nano RX; Pi UART RX → Nano TX
- Camera: Connect 15 Camera 3 to Pi's CSI/DSI connector
- Time estimate: 15 minutes

**Step 6: Mount Electronics in Chassis**
- Place battery in center of base plate (battery holder)
- Mount PCB on second story PCB holder
- Mount Raspberry Pi on third story Pi holder
- Secure camera on camera stand at 155° angle
- Time estimate: 10 minutes
- Mechanical check: No loose wires; all components secured

**Electrical Testing Checkpoint:**
- [ ] Battery reads 12.8V
- [ ] 5V rail reads 5.0V ± 0.1V
- [ ] 8.4V servo rail reads 8.4V ± 0.2V
- [ ] All GND connections are solid (multimeter reads 0Ω between points)
- [ ] Motor driver responds to PWM commands (test with function generator)
- [ ] Servo moves smoothly when sent PWM signal (use Nano test code)
- [ ] Camera captures frames

---

#### Phase 3: Software Setup (1-2 hours)

**Step 1: Set Up Raspberry Pi**

- Follow the complete guide: [Raspberry Pi Setup](https://github.com/JumpyTruck/WRO-FE-2026-Sin-Theta/blob/main/code/md/raspberrypi_setup.md)
- This covers OS updates, camera setup, dependencies, and pulling this repo onto the Pi.
- Time estimate: 30-45 minutes
- Verification: `python3 ObstacleChallenge.py` runs and the status LED turns on, waiting for the start button.

**Step 2: Load Arduino Firmware and Verify Pi-Nano Communications**

- Test serial communication between Raspberry Pi and Arduino Nano: [Serial Test](code/Serial%20Test%20Code/README.md)
- Download the Arduino motor controller code: [Arduino Nano Code](https://github.com/JumpyTruck/WRO-FE-2026-Sin-Theta/blob/main/code/Arduino_Serial.ino)
- Time estimate: 15 minutes

**Step 3: Tune Color Detection**

- Run LAB Adjuster ([labadjuster.py](https://github.com/JumpyTruck/WRO-FE-2026-Sin-Theta/blob/main/code/labadjuster.py))
- For each color (blue, green, red, orange, pink):
  - Show actual obstacle/line on track
  - Adjust LAB thresholds until detection is 100%+ accurate, in various positions and lighting conditions
  - Save thresholds to [Obstacle Challenge](code/ObstacleChallenge.py)
- Time estimate: 20-30 minutes
- Test: Run on practice mat; verify all colors detected reliably

**Software Testing Checkpoint**

- [ ] Raspberry Pi boots and runs Python scripts
- [ ] Arduino Nano receives and executes motor commands
- [ ] Serial communication between Pi and Nano is reliable (no dropped packets)
- [ ] Camera captures clear frames with correct white balance
- [ ] Color detection identifies all 5 colors (blue, green, red, orange, pink) reliably
- [ ] No Python syntax errors or import failures

---

#### Phase 4: First Test Run on Practice Mat (30 minutes)

**Step 1: Safety Check**
- Robot is on a raised stand (not on ground yet)
- Motor is powered but wheels can spin freely
- No loose wires or parts
- Camera has clear view
- All emergency stops are accessible

**Step 2: Test Wall Following**
- Place robot on mat with left wall nearby
- Run wall-following mode only (no obstacles)
- Expected: Robot hugs the left wall, maintains consistent distance
- Measure: Distance to wall should vary <2cm throughout lap
- If fails: Adjust `AREA_WALL_KP` and `AREA_WALL_KD` in code ([Open Challenge](code/OpenChallenge.py), [Obstacle Challenge](code/ObstacleChallenge.py))

**Step 3: Test Obstacle Avoidance**
- Place green obstacle in path
- Run obstacle avoidance mode
- Expected: Robot steers left to avoid, then returns to wall
- Measure: Minimum clearance from obstacle should be >5cm
- Test with: Green, Red, Orange obstacles at different distances (20cm, 50cm, 80cm)
- If fails: Adjust `GREEN_PILLAR_KP`, `RED_PILLAR_KP`, `PILLAR_STEER_OFFSET_DEG`

**Step 4: Test Complete Run**
- Run full state machine (wait → warmup → drive laps → park)
- Expected: Robot completes 3 laps + parks in pink zone
- Measure: Lap time, parking accuracy, any crashes
- Record results in testing log

**Step 5: Run Combinations**
- Run the ([Random Combination Generator](https://github.com/JumpyTruck/WRO-FE-2026-Sin-Theta/blob/main/code/Random%20Combination%20Generator/Obstacle_Random_Gen.py)) to test all combinations of obstacles, to tweak the code for overall consistency

**First Test Checkpoint:**
- [ ] Robot can wall-follow for 1 full lap without crashing
- [ ] Robot avoids obstacles without overshooting
- [ ] Motor encoder ticks match expected wheel rotations
- [ ] Processing latency is consistent ~150ms
- [ ] No thermal issues (touch PCB, motor driver, regulators — all cool)

---

### Future Improvements

1) Implement dynamic colour ranges to improve obstacle, line and parking block detection in a multitude of lighting conditions.
2) Lock camera exposure and white balance after warm-up so colours stay consistent for the whole run.
3) Remember the pillar layout from lap 1 to plan faster, smoother paths for laps 2 and 3, removes inconsistency between laps.
4) Add battery voltage monitoring to warn us before running on a low battery.
5) Add a main fuse on the battery output to protect the wiring between the battery and the converters from short circuits.

Check the Github Issues Section for more detail

---

### Engineering Journal

Our full engineering journal — including trade-offs, constraints, and the reasoning behind every major decision — is documented here.

[Go to Engineering Journal](https://github.com/JumpyTruck/WRO-FE-2026-Sin-Theta/blob/main/Sin%20Theta%20Engineering%20Journal.pdf)

---

### Special Thanks

We would like to give a special thank you to our coach and mentor, Coach Vikram, who guided and helped us extremely well through this competition season. His expertise and support was key to this years success, from helping us when we blew up our pcb to being with us the tune the robot runs, he was always there for us, letting us grow while sharpening our problem-solving skills. We could have not asked for a better coach!
