JumpyTruck/WRO-FE-2026-Sin-Theta/models/README.md

# Mobility & Mechanical Design

This page covers the mechanical design of our robot — the reasoning behind our design choices, and a part-by-part breakdown of the chassis, steering, and rear axle, along with how to assemble it.

All STL and PNG files are in [this folder](https://github.com/JumpyTruck/WRO-FE-2026-Sin-Theta/tree/main/models/CAD%203D%20Printed%20Parts).

---

## 1. Basic Design Choices

### 1.1 Dimensions

The chassis is sized around the Raspberry Pi, driver board, motor, and steering mechanism, with a ~50 mm margin on each side. Inspired by F1 cars, we made it narrow and long: the narrow width lets it fit between pillars and walls, and the longer wheelbase keeps it stable at speed.



---

### 1.2 Wheel Choice

SPIKE Prime wheels (56 mm diameter, 14 mm thick). Best balance of grip, clearance, and compactness — bigger hurts turning, smaller loses clearance.

Spike Wheels

---

### 1.3 Differential

Went with metal over 3D-printed gears (wear fast, mesh poorly) or LEGO (bulkier, higher CG). Metal meshes smoother, lasts longer, and sits lower.

metal diff

---

### 1.4 Steering — Ackermann

Last year we used parallel steering, which scrubbed tires through corners since both wheels turned on the same radius. Switched to Ackermann so each wheel turns its own correct radius.

<table>
  <tr>
    <th align="center">Old</th>
    <th align="center">New</th>
  </tr>
  <tr>
    <td align="center">
      
    </td>
    <td align="center">
      
    </td>
  </tr>
</table>

---

## 2. The Assembly

### 2.1 Chassis

Three stacked, modular plates — any layer pulls off without touching the others.

#### Base Plate

- Steering holder: trapezoid front section, 4 holes, servo cutout.
- Battery holder: front-mounted, low, counterbalances rear motor.
- Motor mount: mid-rear, upper/lower halves clamp the motor.
- Rear axle points: cutouts + mounts for rear axle casing.

<table>
  <tr>
    <td align="center">
      <strong>Base Plate — CAD</strong><br>
      Chassis
    </td>
  </tr>
  <tr>
    <td align="center">
      <strong>Base Plate — Installed</strong><br>
      FirstPlate
    </td>
  </tr>
</table>

#### Motor Mount — Top Half

Clamps over the motor, bolts into the lower half.

<table>
  <tr>
    <td align="center">
      <strong>Motor Mount Top — CAD</strong><br>
      Top Motor Holder
    </td>
  </tr>
  <tr>
    <td align="center">
      <strong>Motor Mount Top — Installed</strong><br>
      
    </td>
  </tr>
</table>

---

#### Second Story — PCB Holder

Holds our custom PCB. Main rectangle seats the PCB, second smaller one houses the servo regulator (also fits our old PCB as backup).

<table>
  <tr>
    <td align="center">
      <strong>Second Story — CAD</strong><br>
      Second_Plate_flipped
    </td>
  </tr>
  <tr>
    <td align="center">
      <strong>Second Story — Installed</strong><br>
      SecondPlate

    </td>
  </tr>
</table>

---

#### Third Story — Pi Holder

This is the holder for the Raspberry Pi, enclosed case for protection, maintaining cutaways for wire attachment sites, mounted lengthwise thus serial wire point rearward to reduce wires sticking out to hit obstacles, includes the Camera Stand which raises the camera for a clear view of the mat.

<table>
  <tr>
    <td align="center">
      <strong>Third Story — CAD</strong><br>
      Pi Reverse
    </td>
  </tr>
  <tr>
    <td align="center">
      <strong>Third Story — Installed</strong><br>
      Third Plate
    </td>
  </tr>
</table>

---

#### Camera Mount

Sits atop the stand and holds the camera. Standalone piece so angle adjusts without touching the stand or top plate. Set to 155°.

<table>
  <tr>
    <td align="center">
      <strong>Camera Mount — CAD</strong><br>
      Camera Mount
    </td>
  </tr>
</table>

<table>
  <tr>
    <td align="center">
      <strong>Full Camera Assembly — Installed</strong><br>
      cameramount_mirrored
    </td>
  </tr>
</table>

---

### 2.2 Steering Assembly

- **Steering holder:** everything mounts here, servo inverted to line up with knuckles.
- **Steering Arm:** fixed at ~12° Ackermann angle, nylon spacers cut friction.
- **Steering T:** extends servo output to the steering bar.
- **Steering Cross Link:** links both knuckles, converts servo rotation into steering.

<table>
  <tr>
    <td align="center">
      <strong>Servo Holder</strong><br>
      Servo Holder
    </td>
    <td align="center">
      <strong>Steering Arm</strong><br>
      Ackermann Steering Arm
    </td>
  </tr>
  <tr>
    <td align="center">
      <strong>Steering T</strong><br>
      Steering T
    </td>
    <td align="center">
      <strong>Steering Cross Link</strong><br>
      Steering Cross Link
    </td>
  </tr>
</table>

<table>
  <tr>
    <td align="center">
      <strong>Full Steering Assembly — Installed</strong><br>
      
    </td>
  </tr>
</table>

---

### 2.3 Rear Axle Assembly

-**Rear axle casing:** this is the housing for the rear axle and the motor adapter, allows everything to mesh together, reduce friction in the axles/differential/adapter, and increase stability in the robots drive system.
- **Motor adapter:** matches motor's D-shaft to the differential's square input. (Print in PETG for toughness and ductility)
- **Axles:** custom metal axles adapt diff output to LEGO wheels.
- **VEX spacers:** added on the rear axles to push the wheels further outward, giving clearance so they don't rub against the chassis/body.

<table>
  <tr>
    <td align="center">
      <strong>Rear Axle Casing</strong><br>
      Full Casing
    </td>
    <td align="center">
      <strong>Inside of View of Rear Axle Casing</strong><br>
      Inside of Casing
    </td>
  </tr>
  <tr>
    <td align="center">
      <strong>Axles</strong><br>
      Rear Axle
    </td>
    <td align="center">
      <strong>Motor Adapter</strong><br>
      Motor Adapter
    </td>
  </tr>
</table>

<table>
  <tr>
    <td align="center">
      <strong>Full Rear Axle Assembly — Installed</strong><br>
      Rear Axle Assembly
    </td>
  </tr>
</table>

### 2.4 Bumper
Our robot features a protruding bumper from the nose of the robot, serving a multitude of purposes:
  1) Prevents the robot from becoming stuck on any wall or obstacle.
  2) The thick tape securing the bumper acts as a shock absorber to reduce stress on the chassis and rest of the robot during crashes.
  3) And of course, a F1 inspired car must have a front wing so we had to add it, sporting our team name “Sin Theta”, letting everyone know which team its running for.

Front Bumper

## 3. Manufacturing & Material Specifications

To ensure the structural integrity, impact resistance, and mechanical reliability of the chassis and drivetrain under competition conditions, all 3D printed parts follow standardized, optimized print profiles.

### 3.1 Slicer Settings & Justification
* **Infill (15% for Chassis / 100% for Motor Adapter):** 
  * *Motor Adapter:* Printed at **100% infill (solid)**. Because it couples the high-torque 12V motor d-shaft directly to the square input of the metal differential, it experiences intense torsional shear and continuous impact stress, requiring maximum material density to prevent stripping or failure.
  * *All Other Parts:* Uses 15% infill to maintain an optimal balance between strength and weight minimization. Higher infill adds unnecessary mass, increasing the robot's center of gravity and degrading acceleration, while 15% provides robust internal scaffolding.
* **Infill Pattern (Gyroid):** Selected over standard grid or linear infills because gyroid infill distributes stress equally in all directions (isotropic strength) and prevents localized weakness during high-impact wall collisions or sudden braking.
* **Wall Loops (5):** Crucial for structural rigidity. Increasing to 5 perimeters/walls significantly enhances outer shell strength, bolt-hole integrity, and snap-fit resilience compared to standard 2-wall setups, preventing parts like motor mounts or steering holders from shearing under high loads.
* **Layer Height (0.2 mm):** Standardized across all structural and mechanical components to provide the ideal balance between print resolution, clean tolerances for interlocking modular plates, and structural layer bonding.
* **Supports:** Automatically generated tree/organic supports enabled specifically for overhangs and complex geometries (such as servo mounts, camera brackets, and internal axle casing overhangs) to ensure clean bridging without compromising dimensional accuracy.

### 3.2 Material Selection (PETG vs. PLA)
* **PLA (Polylactic Acid):** Used for structural and functional parts  (Base plate/Chassis, PCB second story, Raspberry Pi third story/camera holder, as well as steering system) where strength, dimensional accuracy, and lightness are required to keep the robot completely stable during high-speed cornering.
* **PETG (Polyethylene Terephthalate Glycol):** Used specifically for high-stress, high-torque mechanical components such as the **motor adapter** and critical drivetrain housings. PETG was chosen for its superior toughness, layer adhesion, and slight ductility—allowing it to absorb shock and torsional loads from the 12V motor without shattering.
