JumpyTruck/WRO-FE-2026-Sin-Theta/code/Random Combination Generator/playfield.png

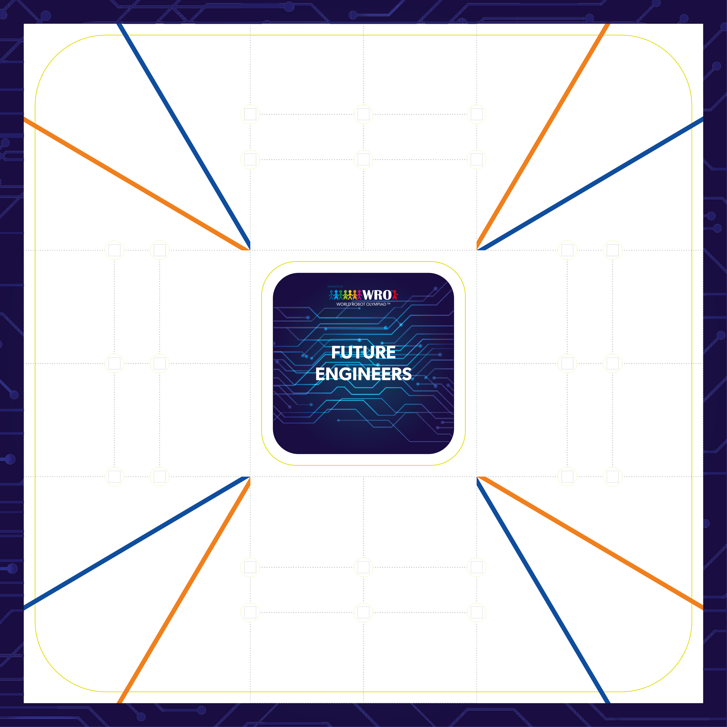
code/Random Combination Generator/playfield.png
