JumpyTruck/WRO-FE-2026-Sin-Theta/electrical/Electrical_Schematic.png

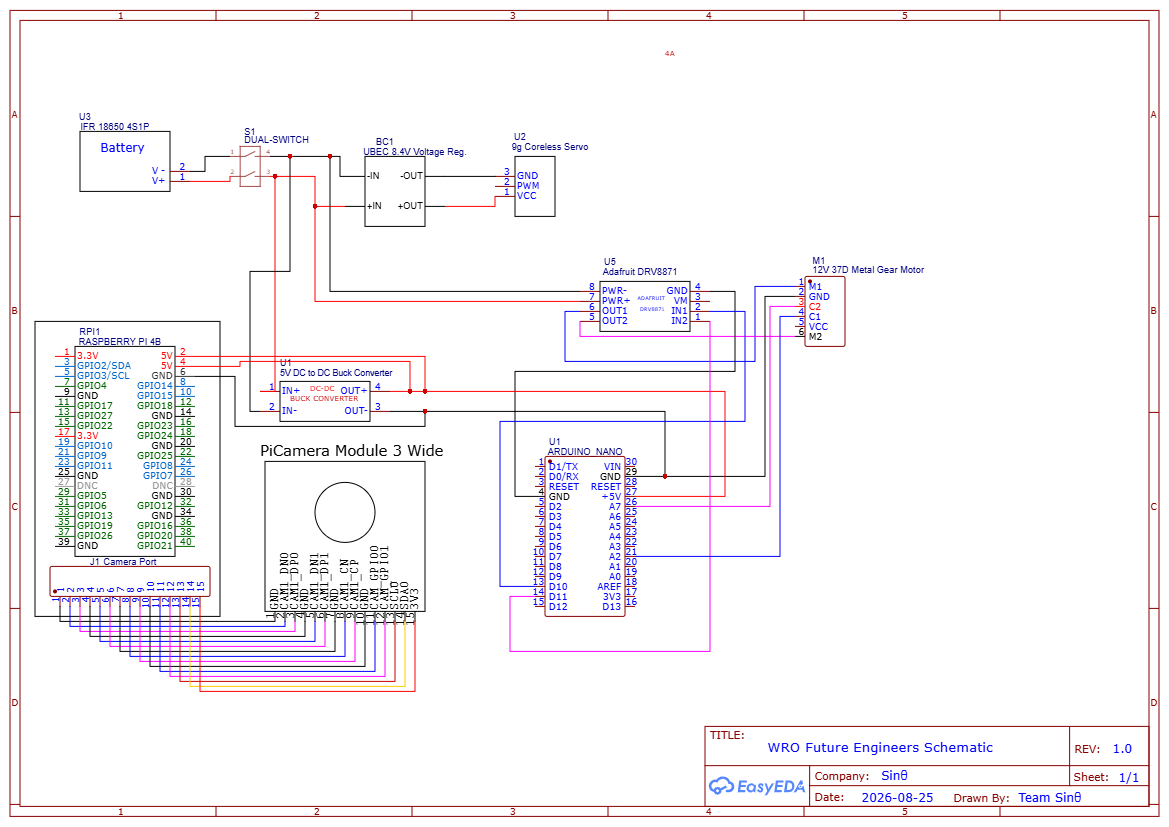
electrical/Electrical_Schematic.png
