JumpyTruck/WRO-FE-2026-Sin-Theta/electrical/Schematic_WRO-Sinθ-Final-Schematics_2026-09-03.png

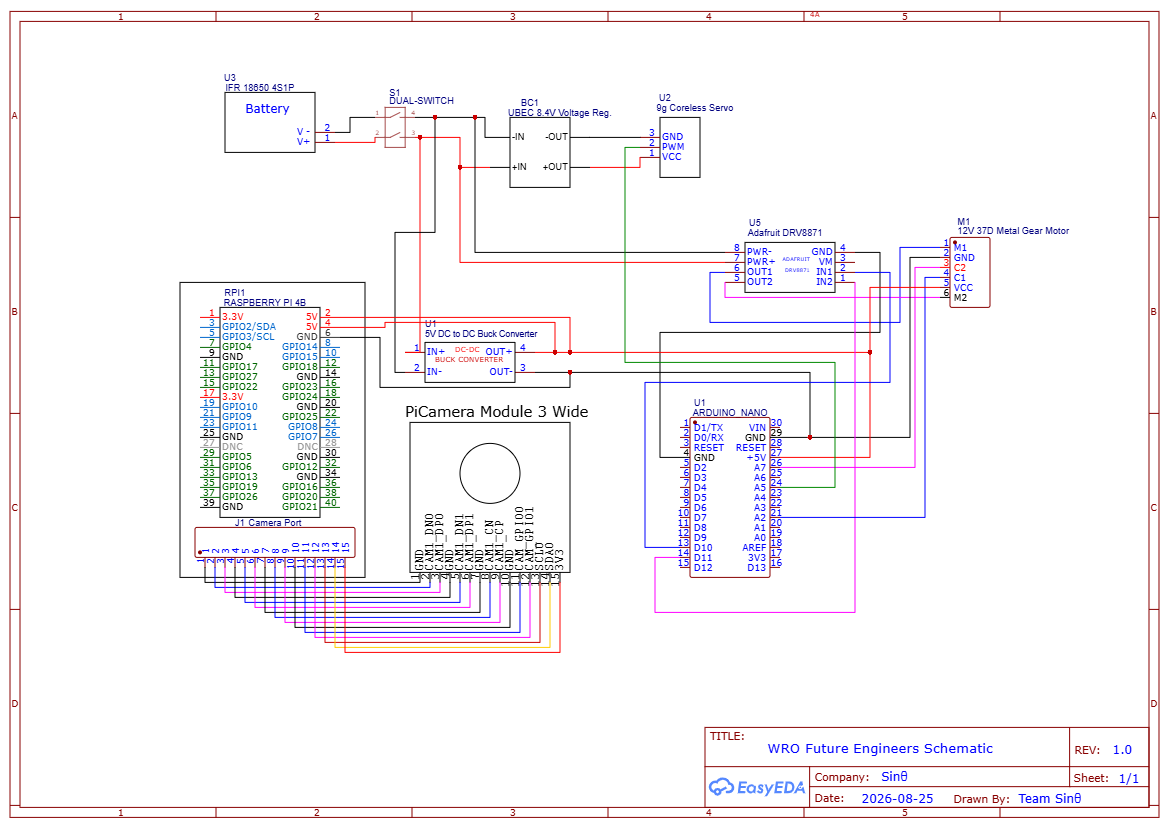
electrical/Schematic_WRO-Sinθ-Final-Schematics_2026-09-03.png
