JumpyTruck/WRO-FE-2026-Sin-Theta/schemes/Schematic.jpeg

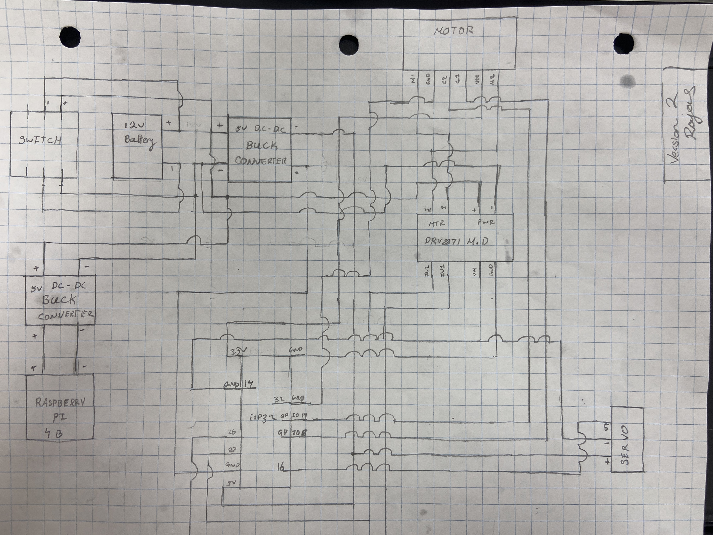
schemes/Schematic.jpeg
