JumpyTruck/WRO-FE-2026-Sin-Theta/t-photos/Funny.jpg

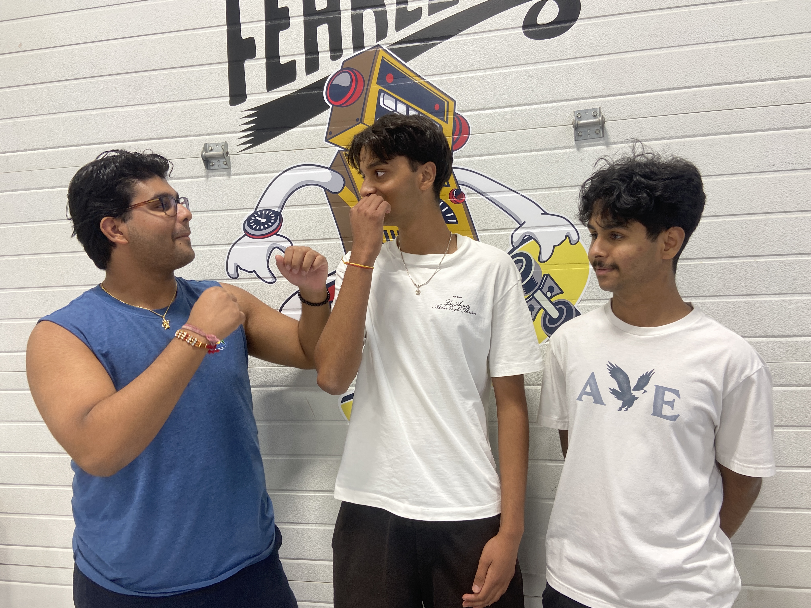
t-photos/Funny.jpg
