JumpyTruck/WRO-FE-2026-Sin-Theta/t-photos/Serious.jpg

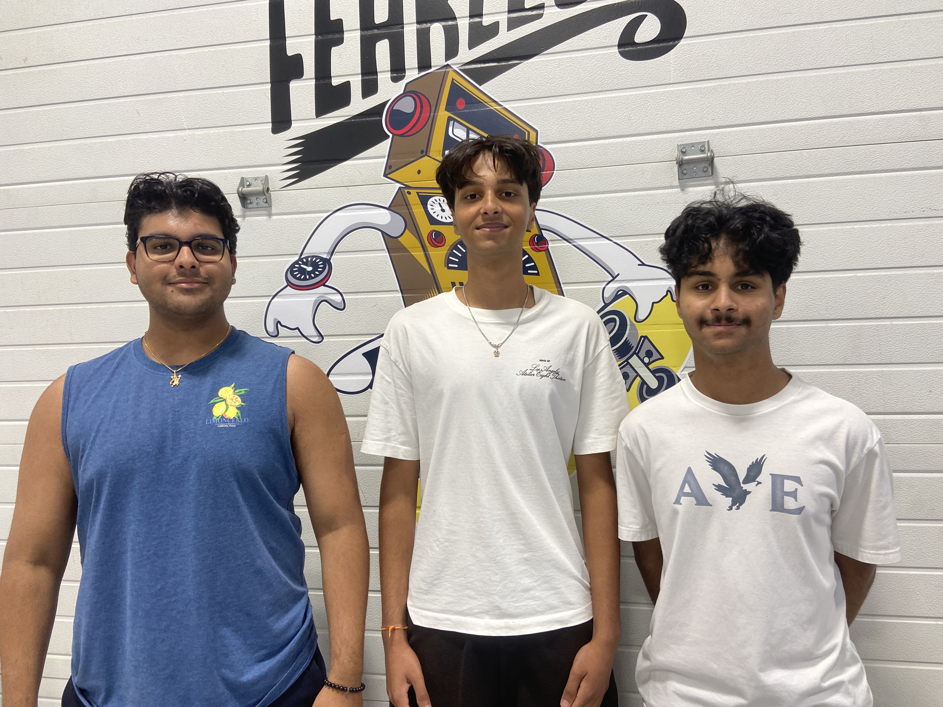
t-photos/Serious.jpg
