JumpyTruck/WRO-FE-2026-Sin-Theta/t-photos/teamphotomain.png

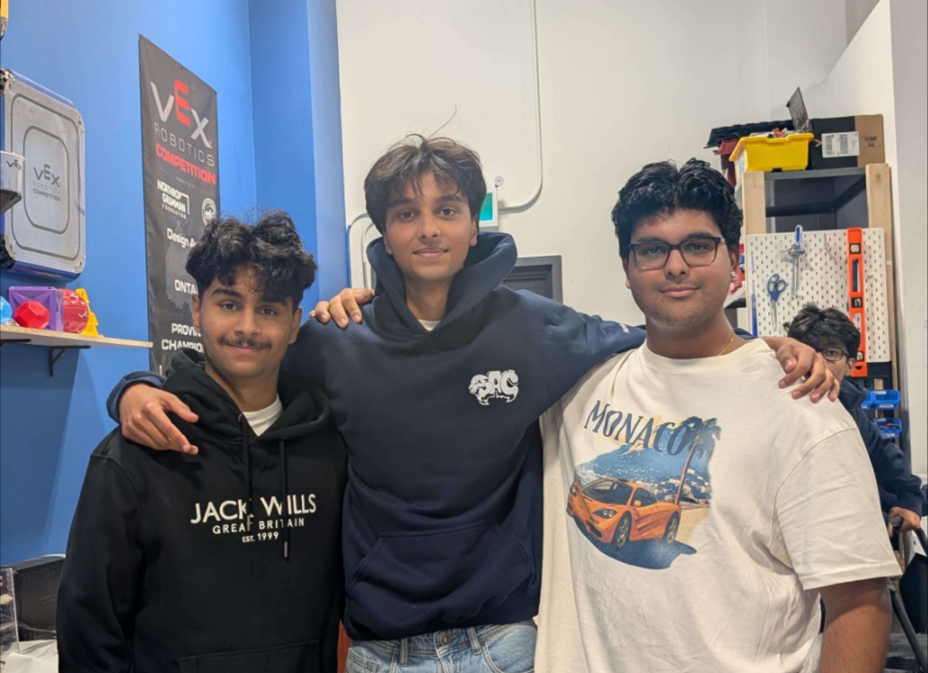
t-photos/teamphotomain.png
