JumpyTruck/WRO-FE-2026-Sin-Theta/v-photos/Bottom.jpeg

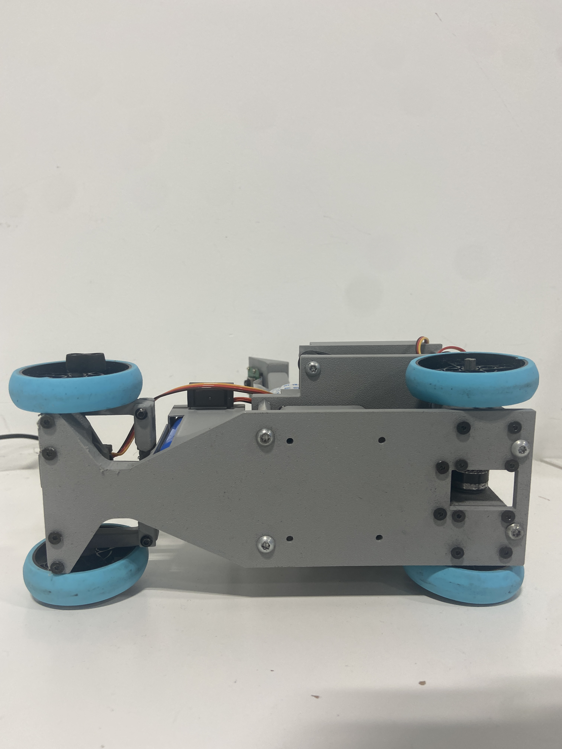
v-photos/Bottom.jpeg
