JumpyTruck/WRO-FE-2026-Sin-Theta/v-photos/Bottom.jpg

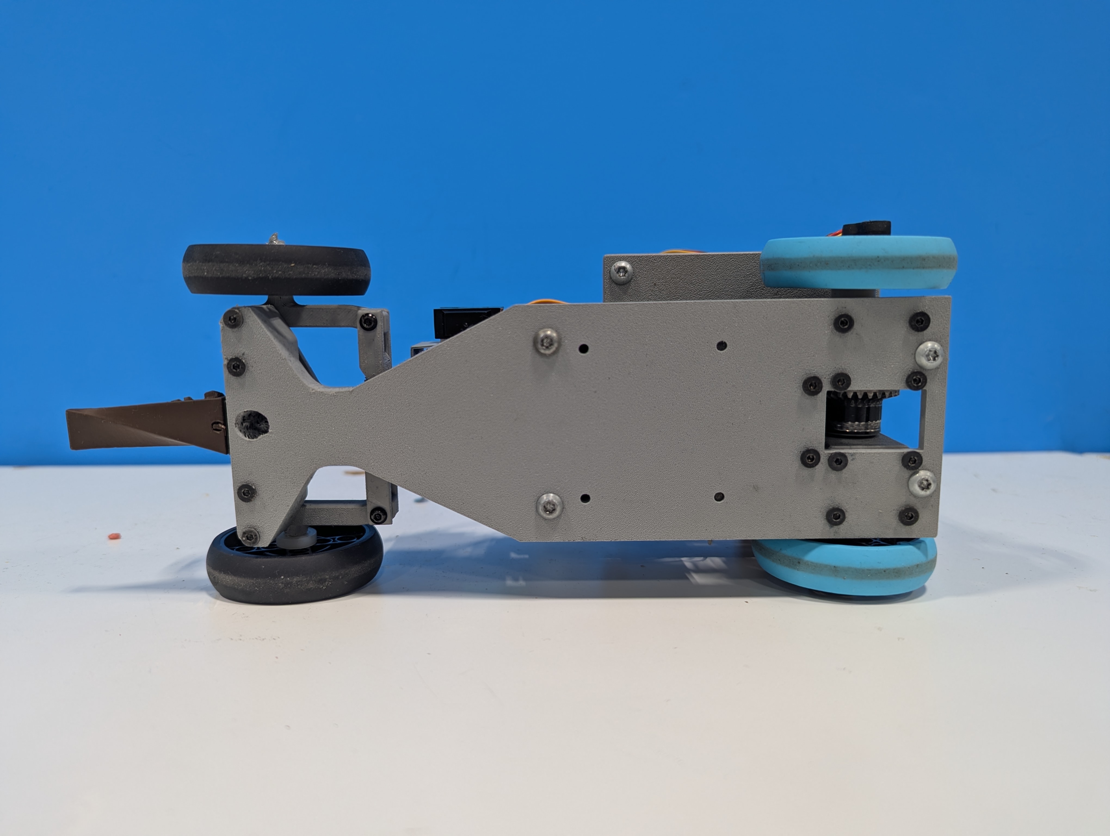
v-photos/Bottom.jpg
