JumpyTruck/WRO-FE-2026-Sin-Theta/v-photos/Front.jpeg

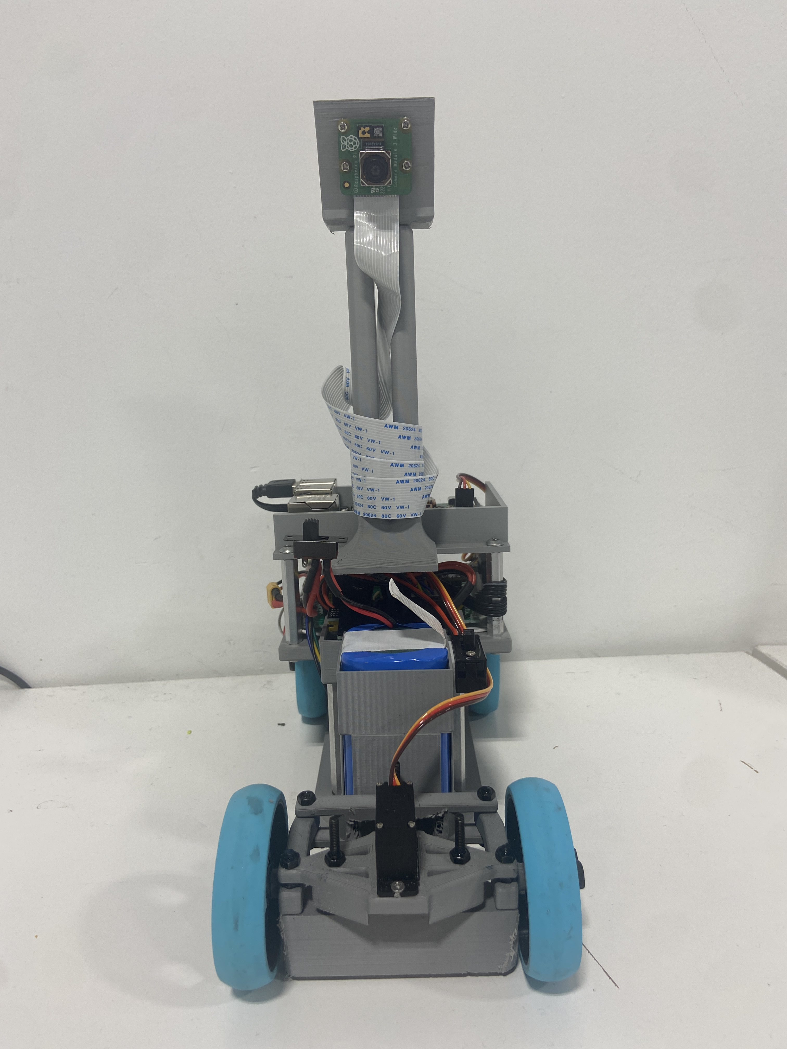
v-photos/Front.jpeg
