JumpyTruck/WRO-FE-2026-Sin-Theta/v-photos/Front.png

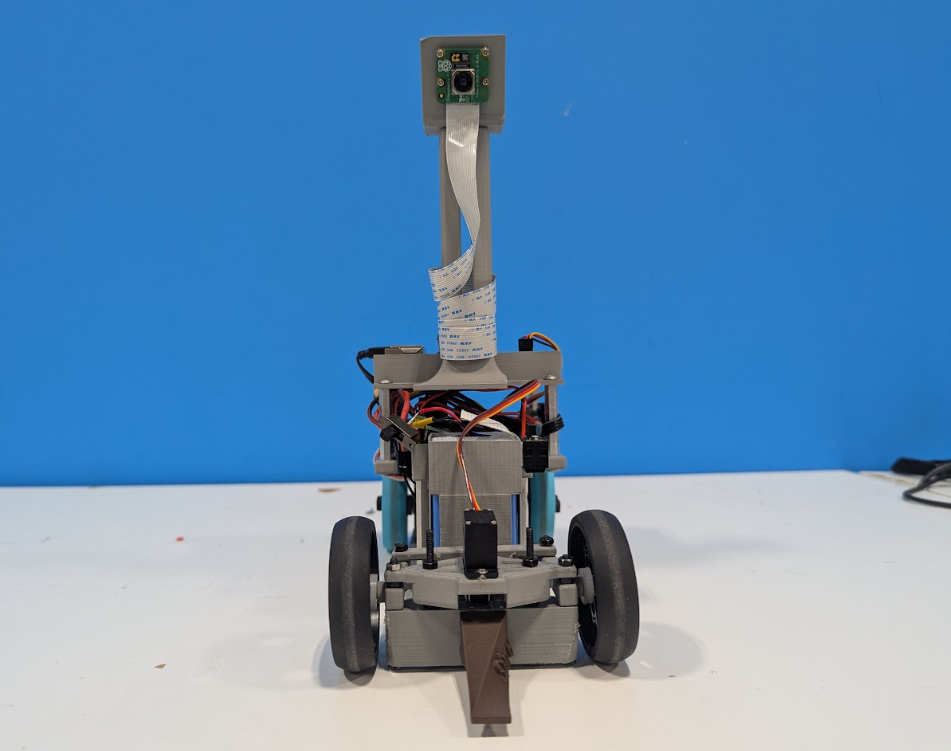
v-photos/Front.png
