JumpyTruck/WRO-FE-2026-Sin-Theta/v-photos/IntersRobotBottom.jpg

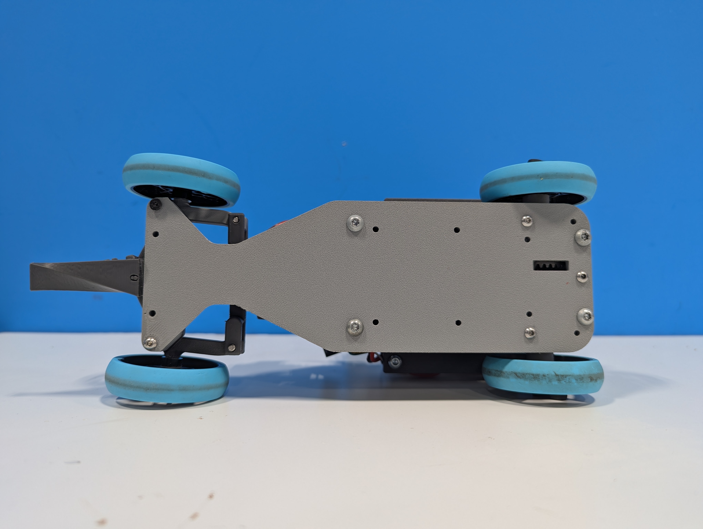
v-photos/IntersRobotBottom.jpg
