JumpyTruck/WRO-FE-2026-Sin-Theta/v-photos/IntersRobotFront.jpg

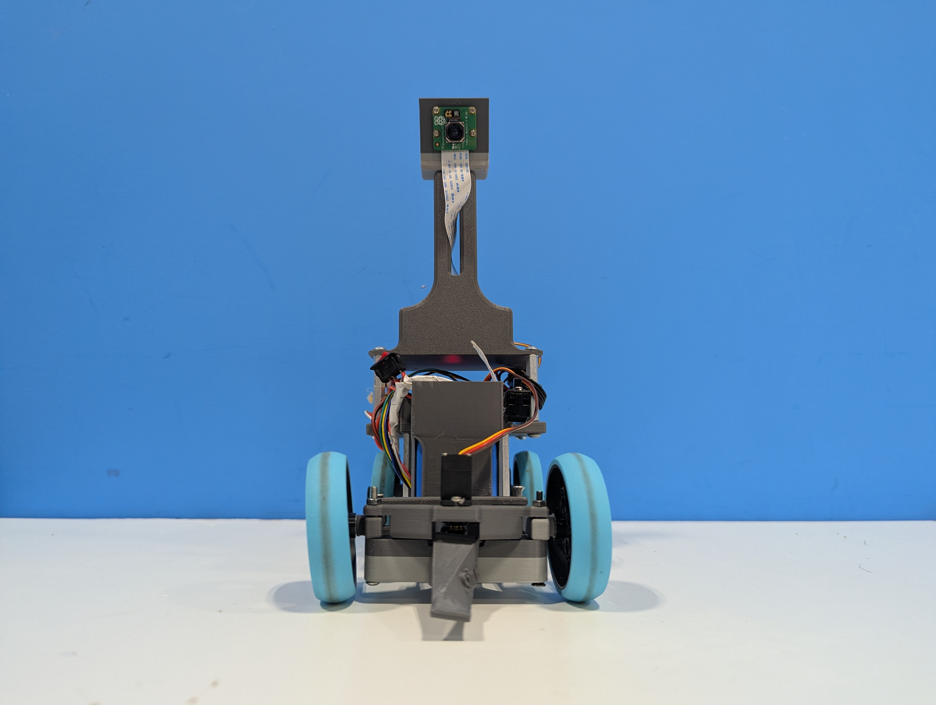
v-photos/IntersRobotFront.jpg
