JumpyTruck/WRO-FE-2026-Sin-Theta/v-photos/IntersRobotLeft.jpg

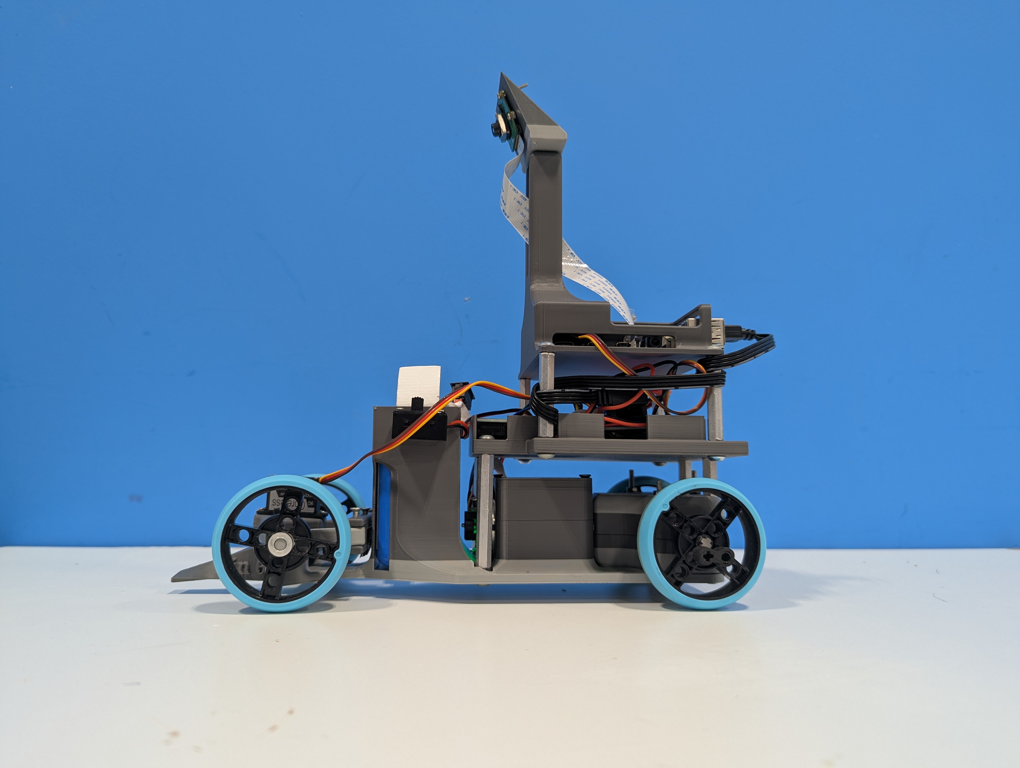
v-photos/IntersRobotLeft.jpg
