JumpyTruck/WRO-FE-2026-Sin-Theta/v-photos/IntersRobotRight.jpg

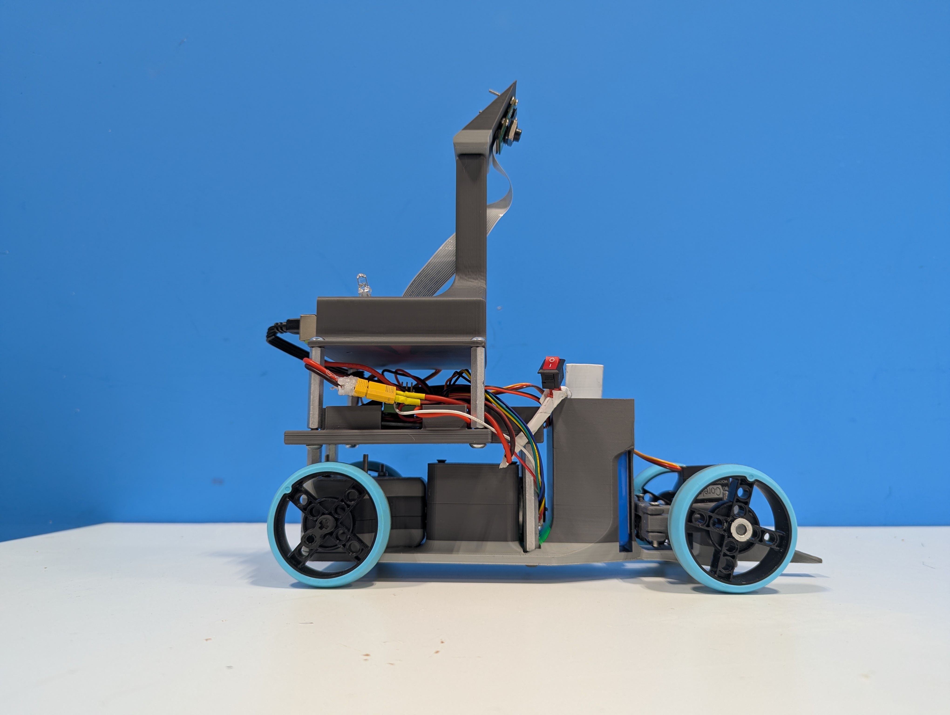
v-photos/IntersRobotRight.jpg
