JumpyTruck/WRO-FE-2026-Sin-Theta/v-photos/IntersRobotTop.jpg

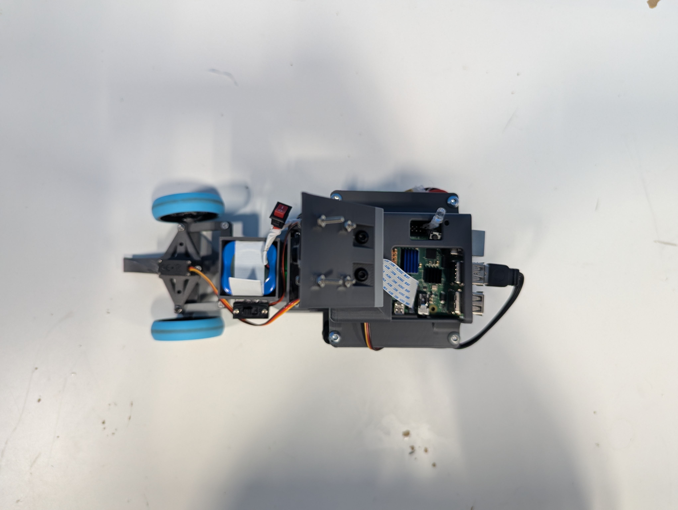
v-photos/IntersRobotTop.jpg
