JumpyTruck/WRO-FE-2026-Sin-Theta/v-photos/Left.jpeg

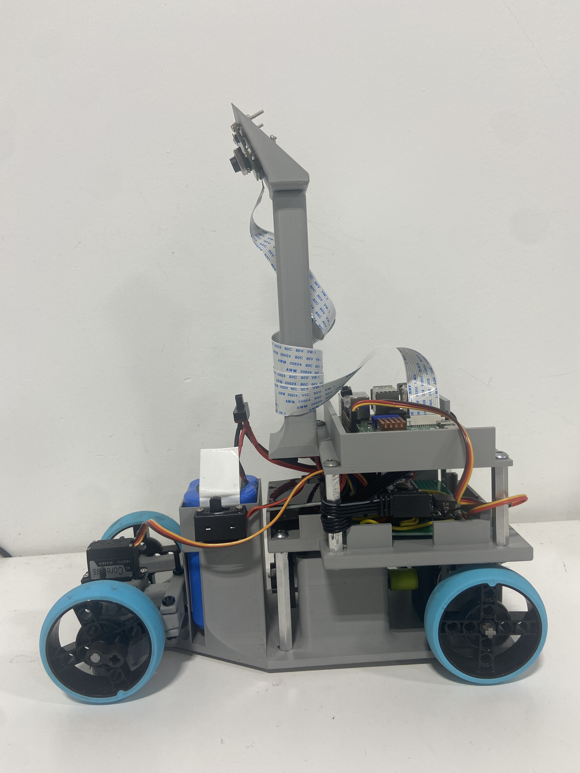
v-photos/Left.jpeg
