JumpyTruck/WRO-FE-2026-Sin-Theta/v-photos/Left.jpg

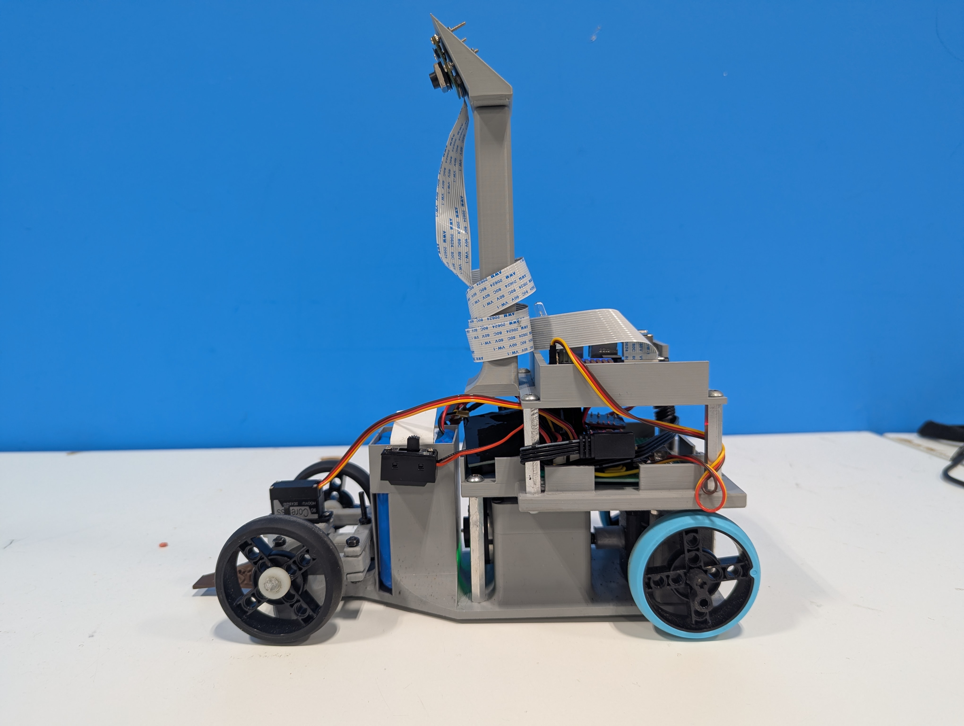
v-photos/Left.jpg
