JumpyTruck/WRO-FE-2026-Sin-Theta/v-photos/Rear.jpeg

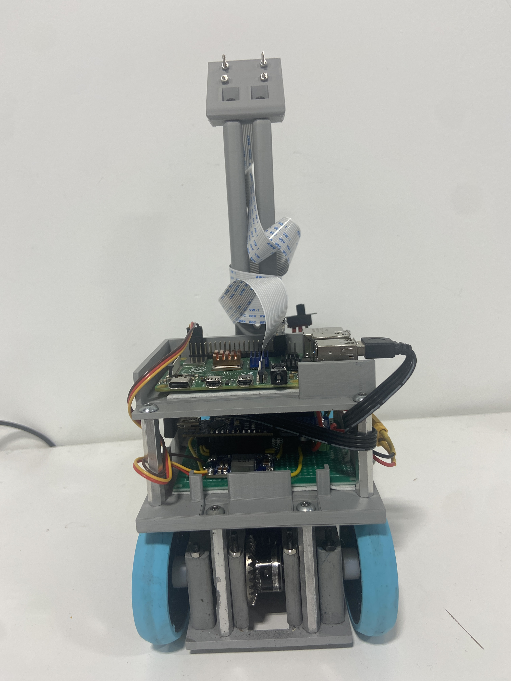
v-photos/Rear.jpeg
