JumpyTruck/WRO-FE-2026-Sin-Theta/v-photos/Rear.jpg

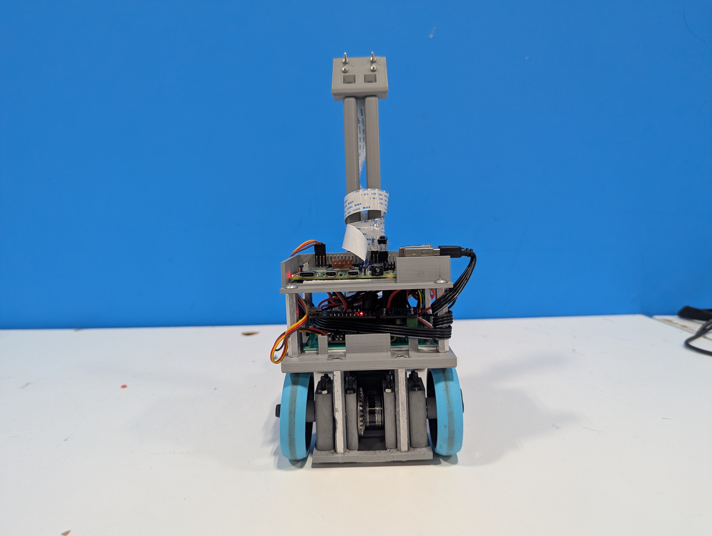
v-photos/Rear.jpg
