JumpyTruck/WRO-FE-2026-Sin-Theta/v-photos/Right.jpeg

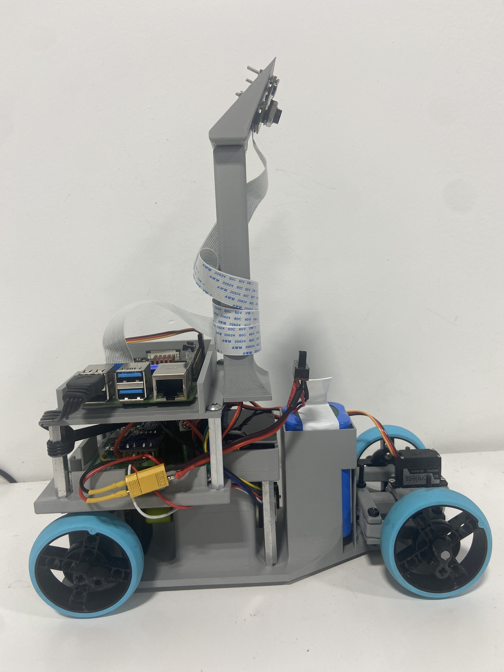
v-photos/Right.jpeg
