JumpyTruck/WRO-FE-2026-Sin-Theta/v-photos/Right.jpg

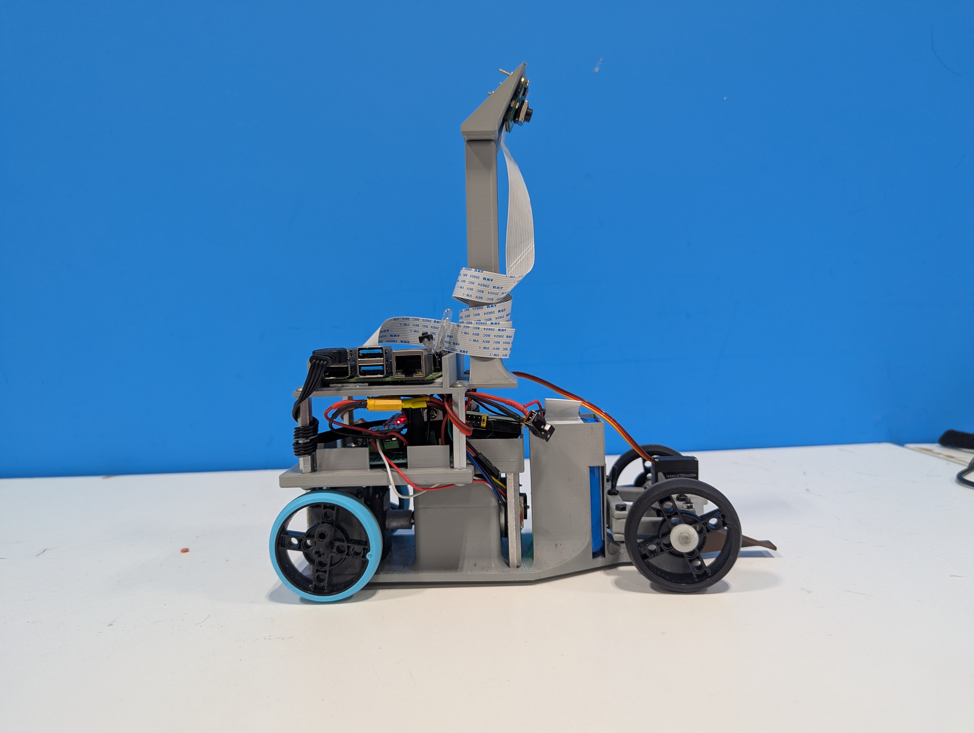
v-photos/Right.jpg
