JumpyTruck/WRO-FE-2026-Sin-Theta/v-photos/Robots.jpg

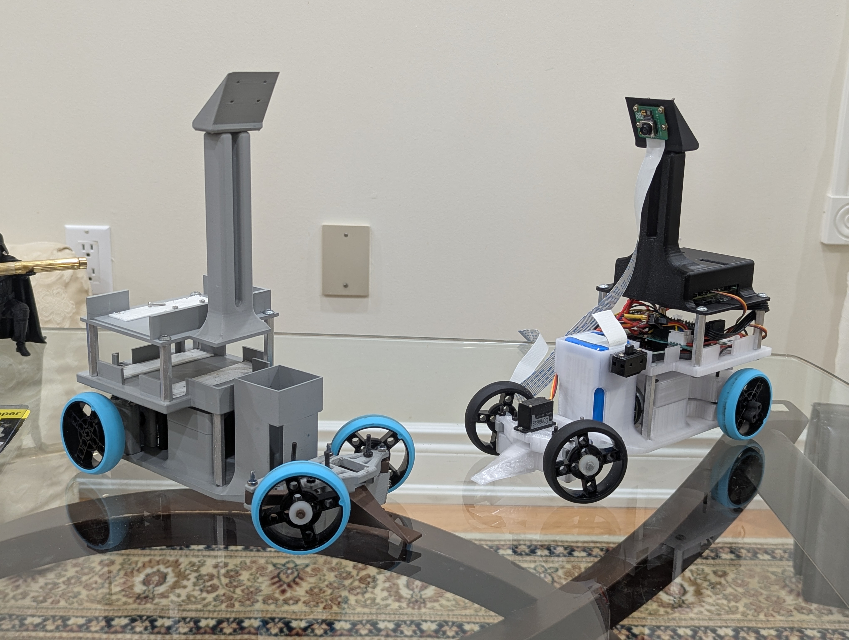
v-photos/Robots.jpg
