JumpyTruck/WRO-FE-2026-Sin-Theta/v-photos/Top (1).jpg

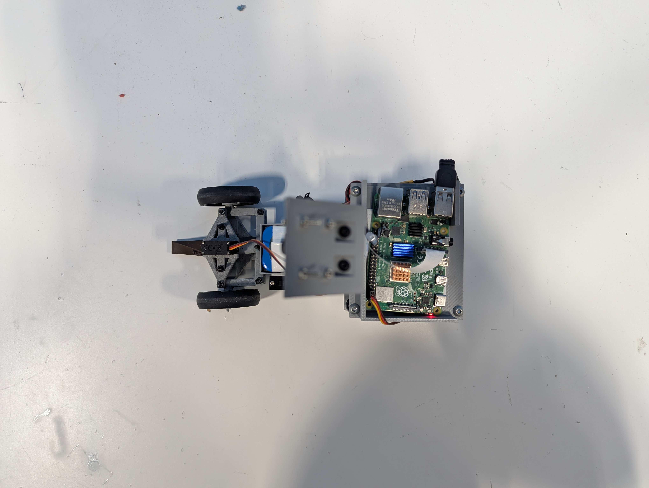
v-photos/Top (1).jpg
