JumpyTruck/WRO-FE-2026-Sin-Theta/v-photos/Top.jpeg

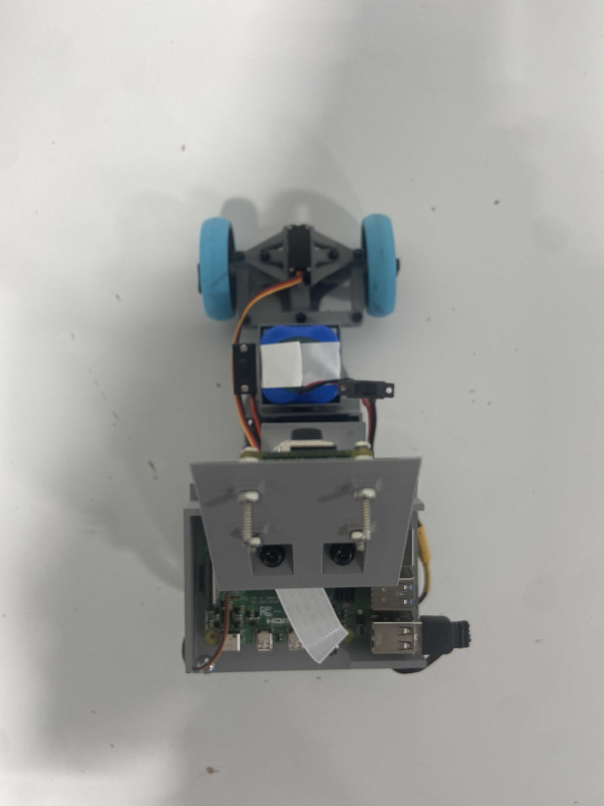
v-photos/Top.jpeg
