JumpyTruck/WRO-FE-2026-Sin-Theta/models/CAD 3D Printed Parts/README.md

# CAD 3D Printed Parts
STL models and visual references for the WRO Future Engineers 2026 Nationals Sin Theta robot.
