JumpyTruck/WRO-FE-2026-Sin-Theta/models/CAD 3D Printed Parts/Inters Robot Files/README.md

# Inters Robot Files
STL models, mechanical assemblies, and visual references for WRO Future Engineers 2026 Internationals Sin Theta robot.
