JumpyTruck/WRO-FE-2026-Sin-Theta/models/CAD 3D Printed Parts/Axle Support.png

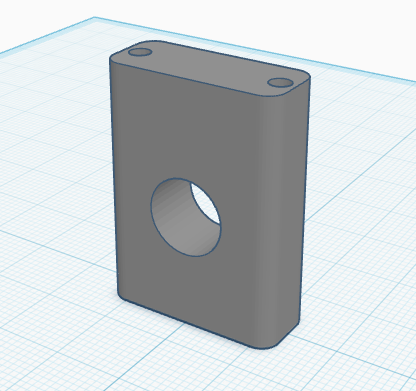
models/CAD 3D Printed Parts/Axle Support.png
