JumpyTruck/WRO-FE-2026-Sin-Theta/models/CAD 3D Printed Parts/Inters Robot Files/Inside of Casing.png

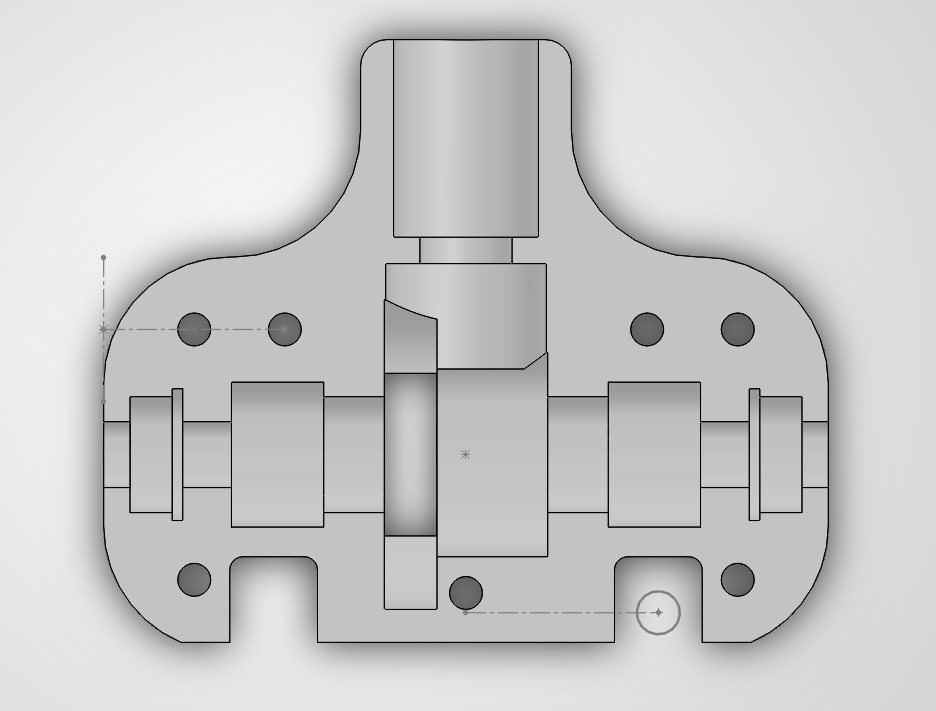
models/CAD 3D Printed Parts/Inters Robot Files/Inside of Casing.png
