JumpyTruck/WRO-FE-2026-Sin-Theta/models/CAD 3D Printed Parts/Inters Robot Files/Motor Adapter.png

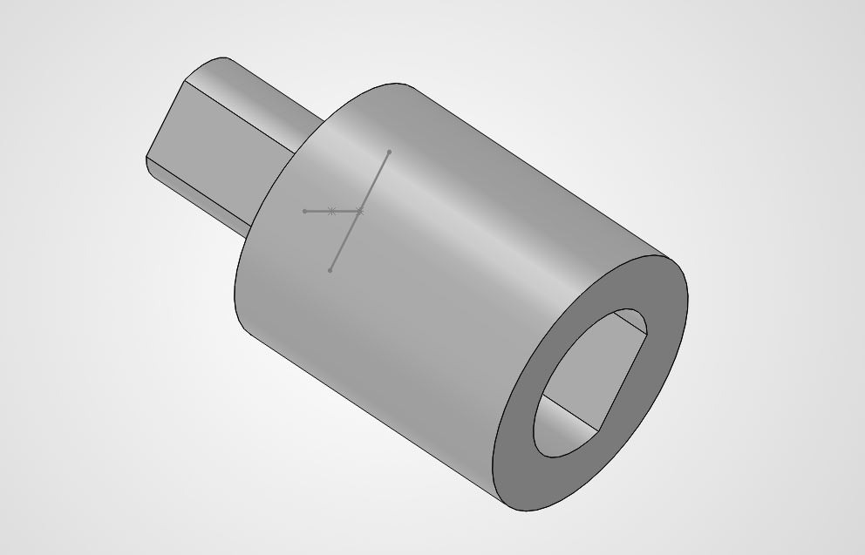
models/CAD 3D Printed Parts/Inters Robot Files/Motor Adapter.png
