JumpyTruck/WRO-FE-2026-Sin-Theta/models/CAD 3D Printed Parts/Inters Robot Files/Pi Reverse.png

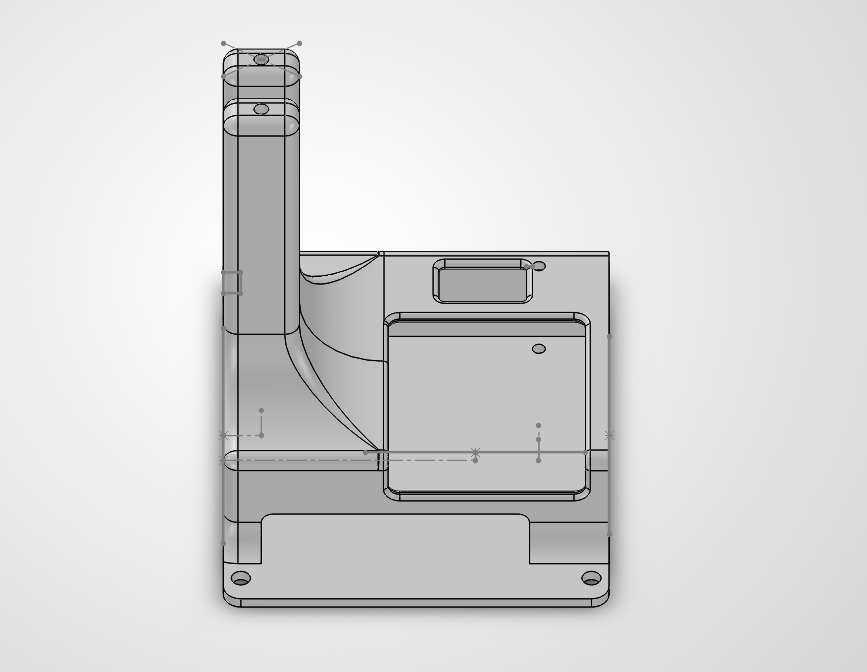
models/CAD 3D Printed Parts/Inters Robot Files/Pi Reverse.png
