JumpyTruck/WRO-FE-2026-Sin-Theta/models/CAD 3D Printed Parts/Inters Robot Files/Steering Cross Link.png

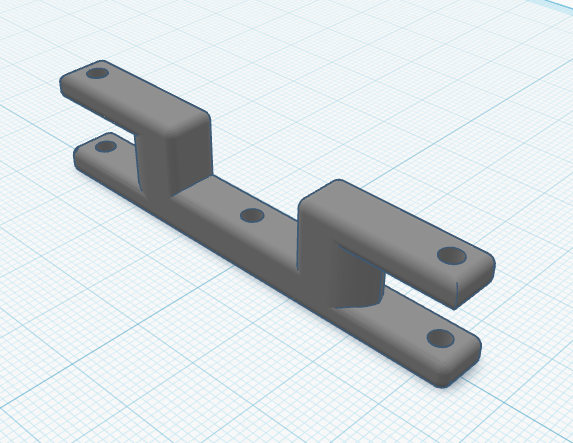
models/CAD 3D Printed Parts/Inters Robot Files/Steering Cross Link.png
