JumpyTruck/WRO-FE-2026-Sin-Theta/models/CAD 3D Printed Parts/Third Plate.png

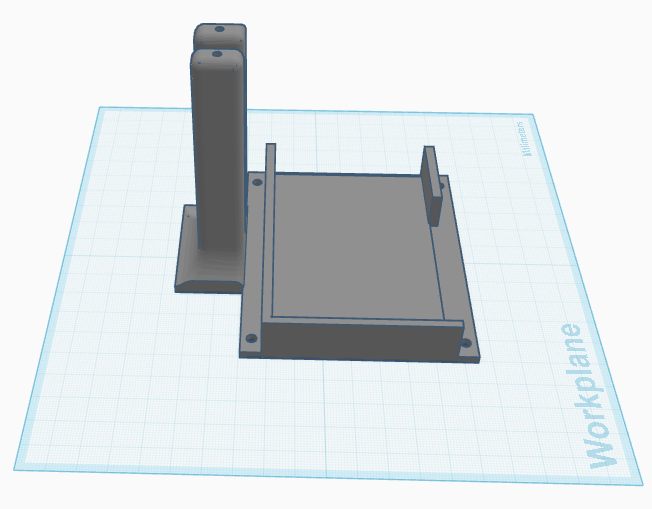
models/CAD 3D Printed Parts/Third Plate.png
