JumpyTruck/WRO-FE-2026-Sin-Theta/models/CAD 3D Printed Parts/Main Chassis (Base Plate).STL

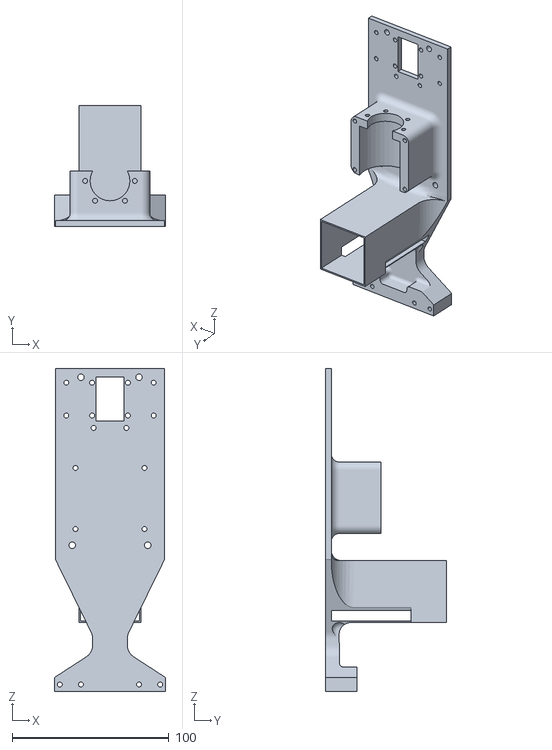
[picture p50: CAD file, 2026-08-23]
models/CAD 3D Printed Parts/Main Chassis (Base Plate).STL
71.1 x 77.5 x 206.4
