JumpyTruck/WRO-FE-2026-Sin-Theta/models/CAD 3D Printed Parts/Bumper.stl

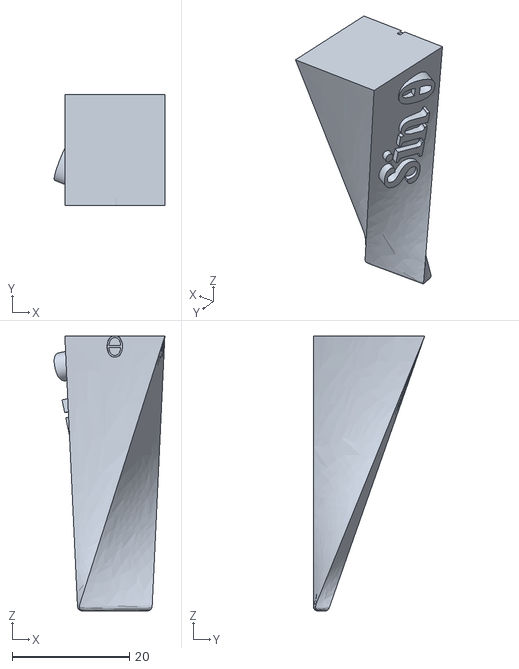
[picture p51: CAD file, 2026-09-05]
models/CAD 3D Printed Parts/Bumper.stl
18.9 x 19.0 x 47.0
