JumpyTruck/WRO-FE-2026-Sin-Theta/models/CAD 3D Printed Parts/Inters Robot Files/Steering Cross Link - Gap - STL.STL

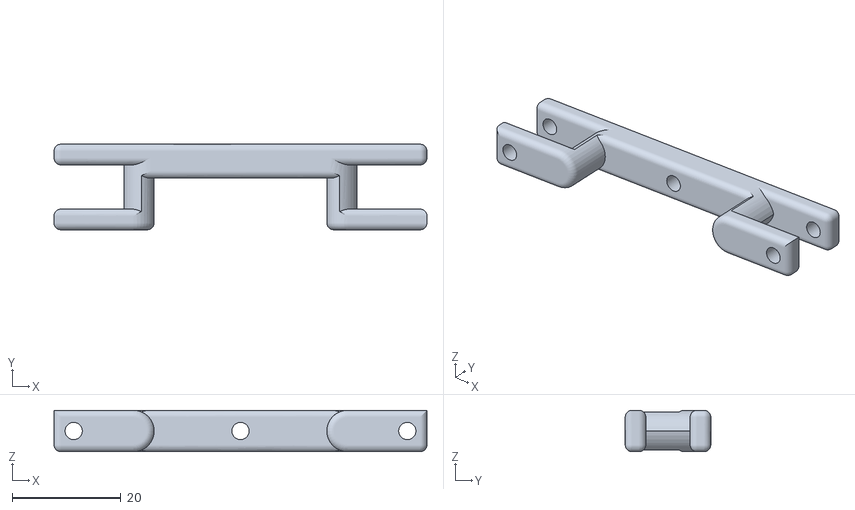
[picture p52: CAD file, 2026-11-10]
models/CAD 3D Printed Parts/Inters Robot Files/Steering Cross Link - Gap - STL.STL
68.6 x 15.7 x 7.62
