JumpyTruck/WRO-FE-2026-Sin-Theta/models/CAD 3D Printed Parts/Axle Support.STL

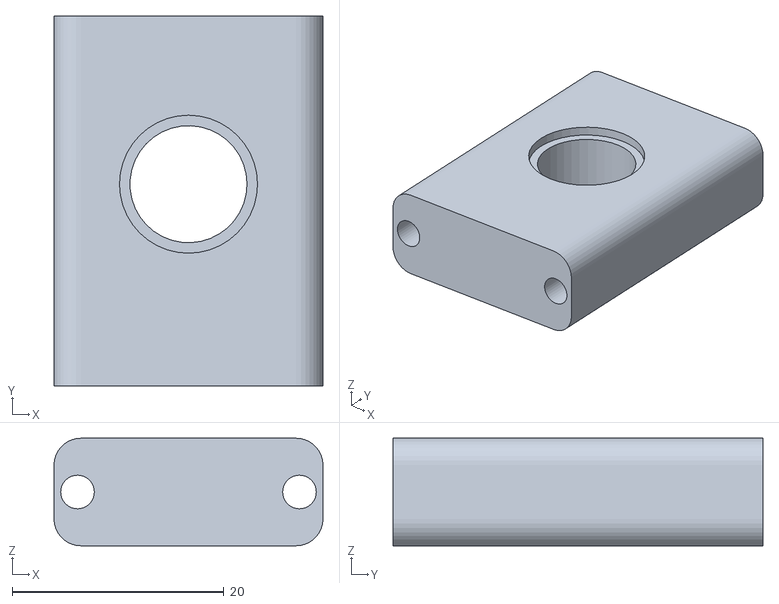
[picture p53: CAD file, 2026-08-24]
models/CAD 3D Printed Parts/Axle Support.STL
25.4 x 34.9 x 10.2
