JumpyTruck/WRO-FE-2026-Sin-Theta/models/CAD 3D Printed Parts/Inters Robot Files/AHTg - STL.STL

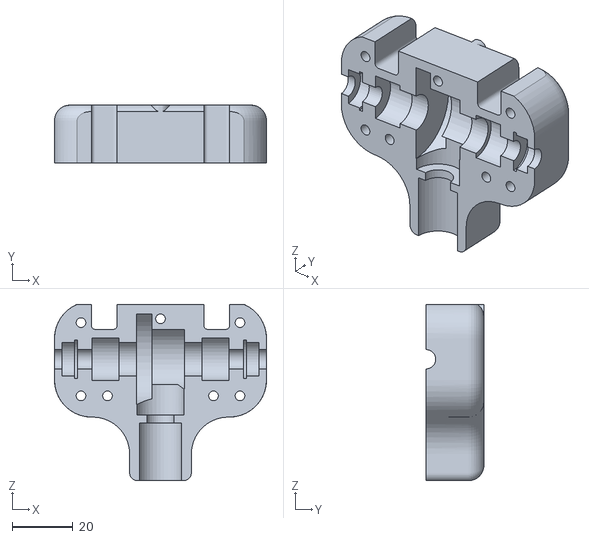
[picture p54: CAD file, 2026-11-10]
models/CAD 3D Printed Parts/Inters Robot Files/AHTg - STL.STL
69.8 x 19.1 x 58.1
