JumpyTruck/WRO-FE-2026-Sin-Theta/models/CAD 3D Printed Parts/Inters Robot Files/Servo Holder Gap Final - STL.STL

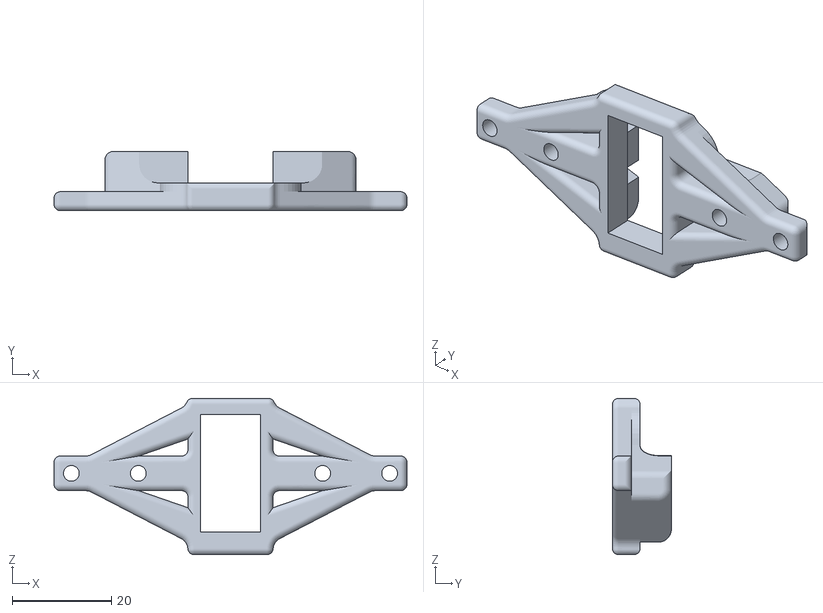
[picture p55: CAD file, 2026-11-10]
models/CAD 3D Printed Parts/Inters Robot Files/Servo Holder Gap Final - STL.STL
71.1 x 11.9 x 31.5
