JumpyTruck/WRO-FE-2026-Sin-Theta/models/CAD 3D Printed Parts/Motor Adapter.STL

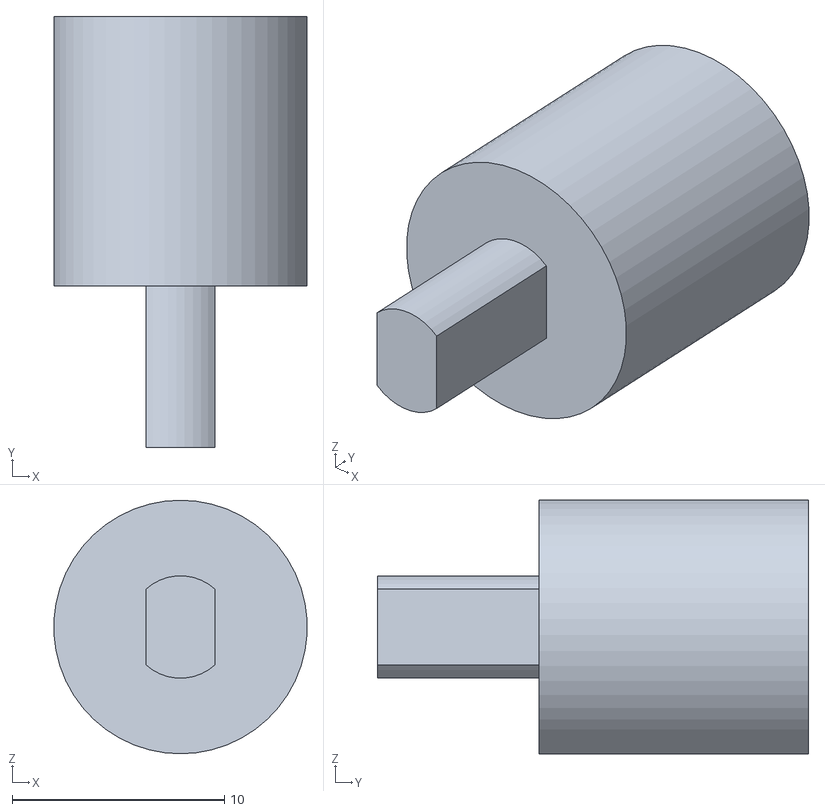
[picture p56: CAD file, 2026-08-24]
models/CAD 3D Printed Parts/Motor Adapter.STL
11.9 x 20.3 x 11.9
