JumpyTruck/WRO-FE-2026-Sin-Theta/models/CAD 3D Printed Parts/Gear Holder.STL

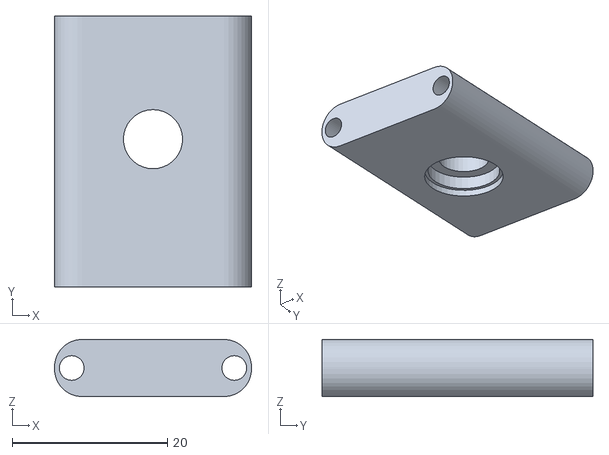
[picture p57: CAD file, 2026-08-24]
models/CAD 3D Printed Parts/Gear Holder.STL
25.4 x 34.9 x 7.37
