JumpyTruck/WRO-FE-2026-Sin-Theta/models/CAD 3D Printed Parts/Inters Robot Files/Motor Cover Top - STL.STL

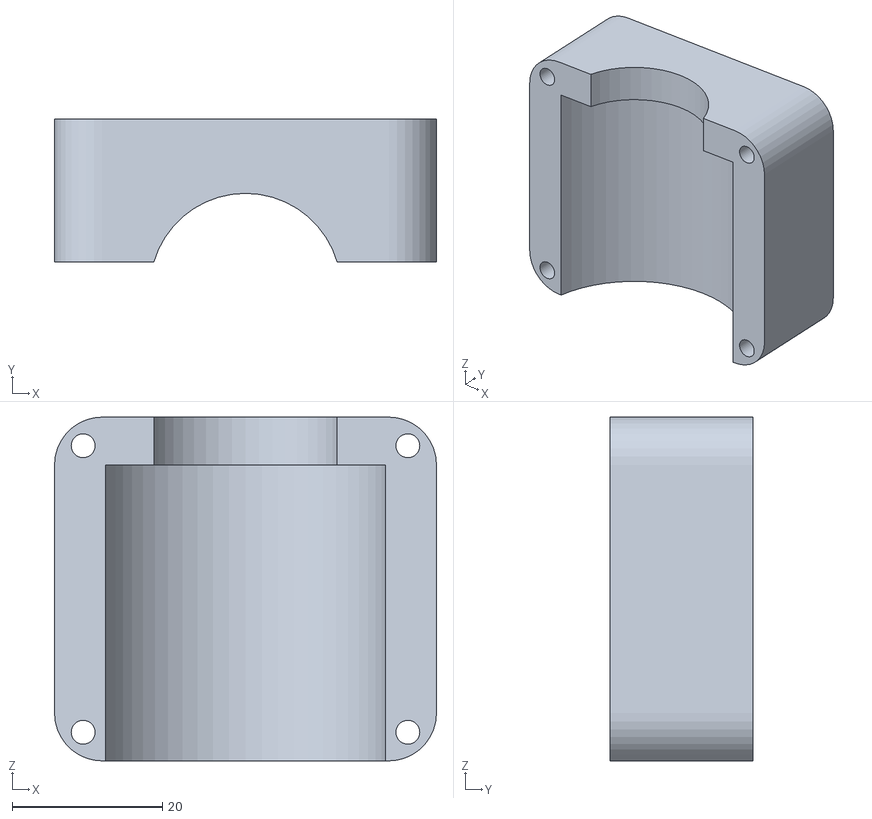
[picture p58: CAD file, 2026-11-10]
models/CAD 3D Printed Parts/Inters Robot Files/Motor Cover Top - STL.STL
50.8 x 19.0 x 45.7
