JumpyTruck/WRO-FE-2026-Sin-Theta/models/CAD 3D Printed Parts/Inters Robot Files/Pi Reverse Gap - STL.STL

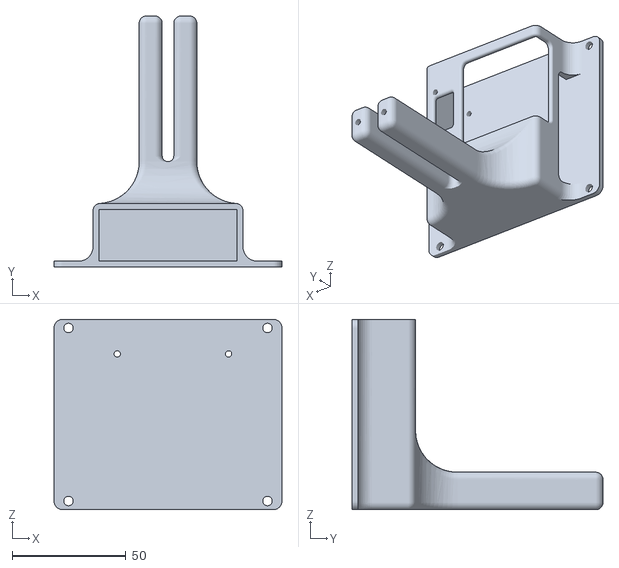
[picture p59: CAD file, 2026-11-10]
models/CAD 3D Printed Parts/Inters Robot Files/Pi Reverse Gap - STL.STL
100.3 x 110.5 x 83.8
