JumpyTruck/WRO-FE-2026-Sin-Theta/models/CAD 3D Printed Parts/Rear Axle.STL

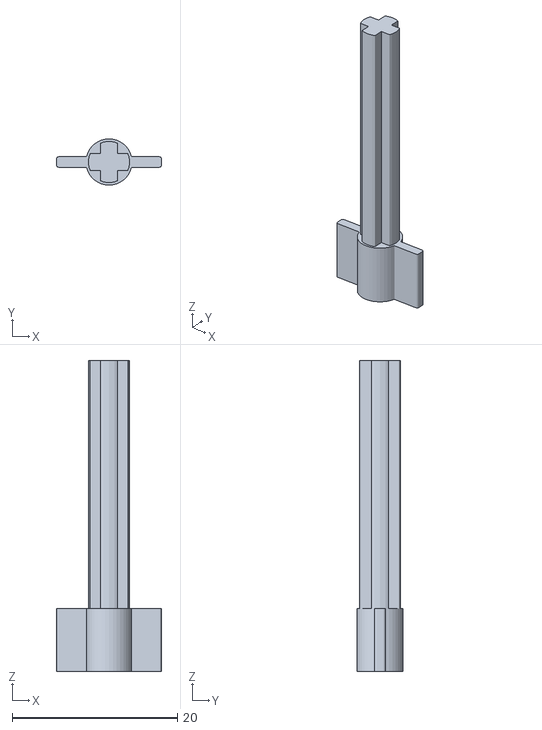
[picture p60: CAD file, 2026-08-24]
models/CAD 3D Printed Parts/Rear Axle.STL
12.7 x 5.60 x 37.6
