JumpyTruck/WRO-FE-2026-Sin-Theta/models/CAD 3D Printed Parts/Camera Mount.STL

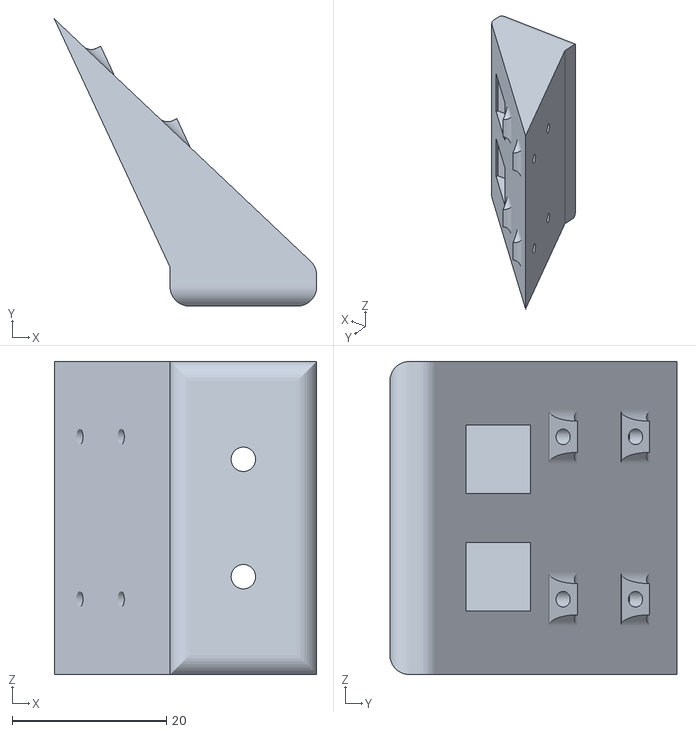
[picture p61: CAD file, 2026-08-24]
models/CAD 3D Printed Parts/Camera Mount.STL
34.1 x 37.3 x 40.6
