JumpyTruck/WRO-FE-2026-Sin-Theta/models/CAD 3D Printed Parts/Inters Robot Files/Chassis - Final Inters - STL.STL

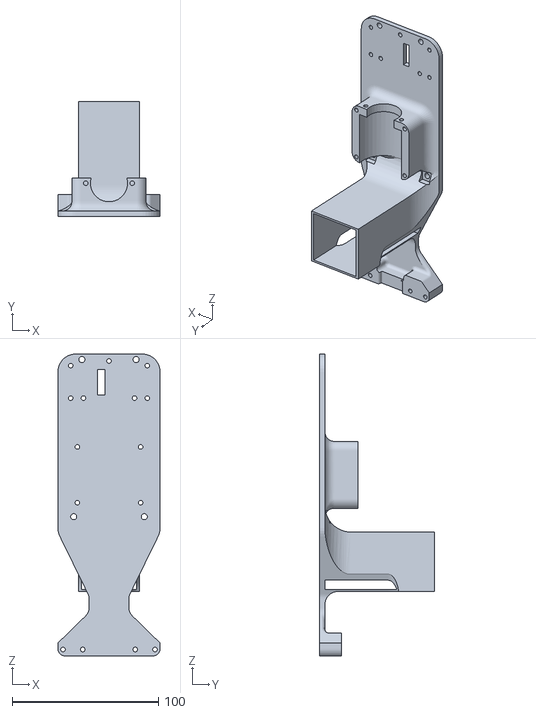
[picture p62: CAD file, 2026-11-10]
models/CAD 3D Printed Parts/Inters Robot Files/Chassis - Final Inters - STL.STL
69.8 x 78.7 x 206.4
