JumpyTruck/WRO-FE-2026-Sin-Theta/models/CAD 3D Printed Parts/Cool Curcan-Stantia.stl

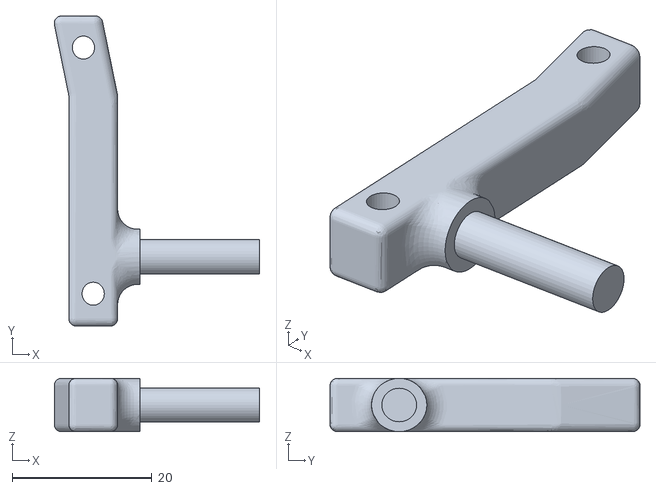
[picture p63: CAD file, 2026-08-23]
models/CAD 3D Printed Parts/Cool Curcan-Stantia.stl
29.4 x 44.3 x 7.62
