JumpyTruck/WRO-FE-2026-Sin-Theta/models/CAD 3D Printed Parts/Inters Robot Files/Axle Housing Bottom - Tall - STL.STL

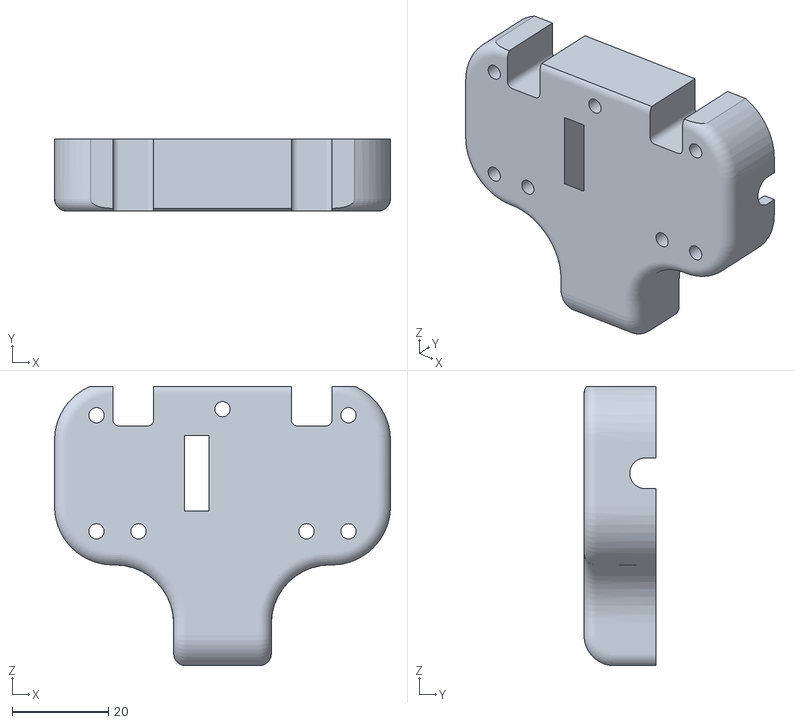
[picture p64: CAD file, 2026-11-10]
models/CAD 3D Printed Parts/Inters Robot Files/Axle Housing Bottom - Tall - STL.STL
69.8 x 15.0 x 58.1
