JumpyTruck/WRO-FE-2026-Sin-Theta/models/CAD 3D Printed Parts/Inters Robot Files/Steering T - Short - STL.STL

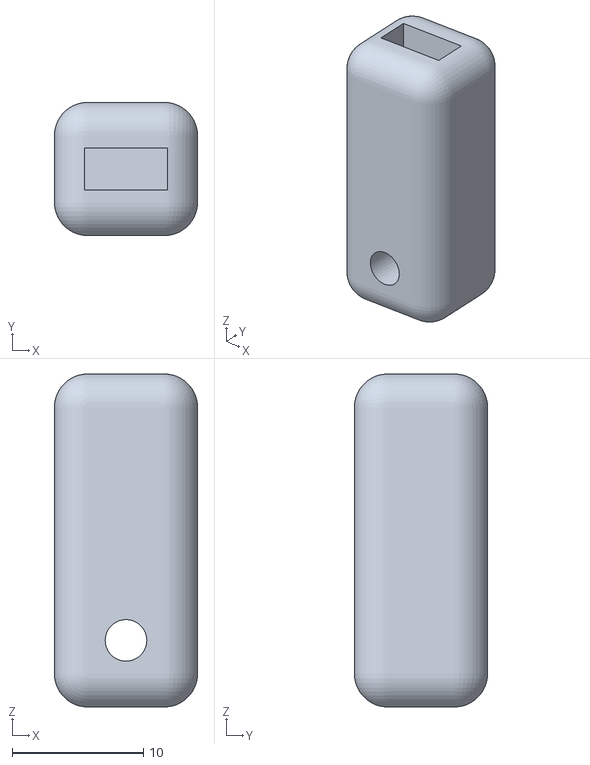
[picture p65: CAD file, 2026-11-10]
models/CAD 3D Printed Parts/Inters Robot Files/Steering T - Short - STL.STL
10.9 x 10.2 x 25.4
