JumpyTruck/WRO-FE-2026-Sin-Theta/models/CAD 3D Printed Parts/Top Motor Holder.STL

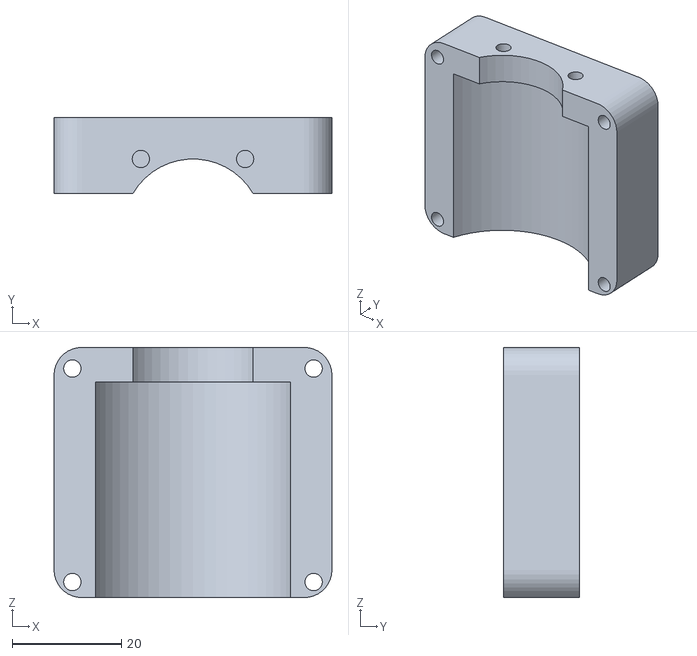
[picture p66: CAD file, 2026-08-23]
models/CAD 3D Printed Parts/Top Motor Holder.STL
50.8 x 14.0 x 45.7
