JumpyTruck/WRO-FE-2026-Sin-Theta/models/CAD 3D Printed Parts/Ackermann Steering Arm.STL

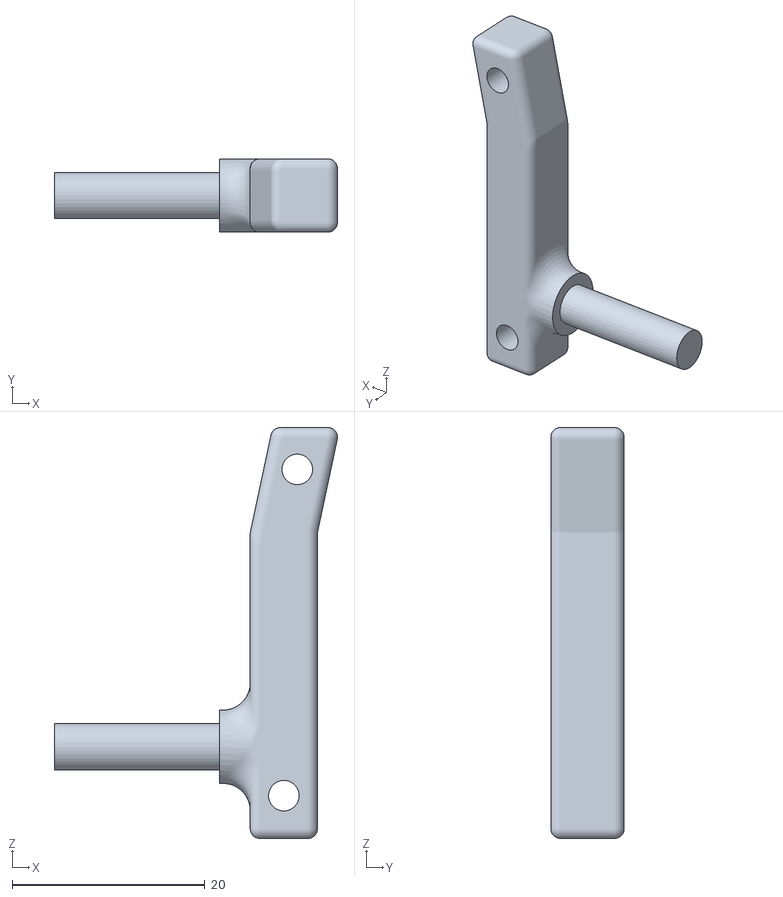
[picture p67: CAD file, 2026-08-23]
models/CAD 3D Printed Parts/Ackermann Steering Arm.STL
29.4 x 7.62 x 42.7
