JumpyTruck/WRO-FE-2026-Sin-Theta/models/CAD 3D Printed Parts/Steering Cross Link.STL

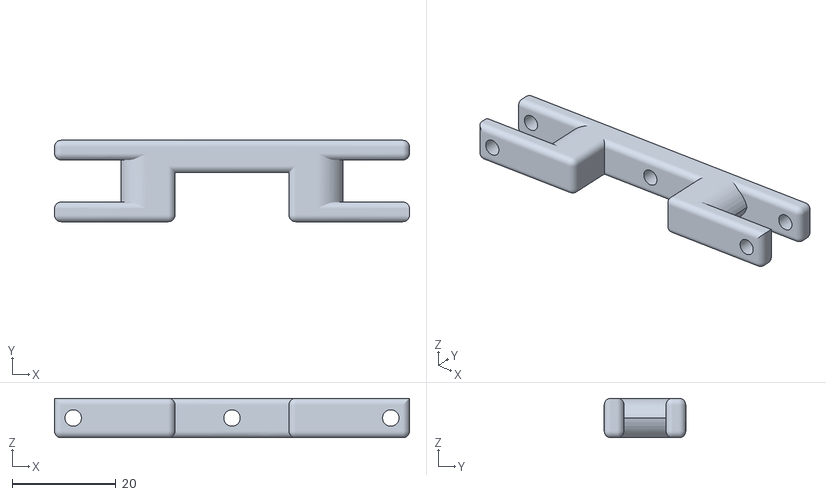
[picture p68: CAD file, 2026-08-23]
models/CAD 3D Printed Parts/Steering Cross Link.STL
68.6 x 15.7 x 7.62
