JumpyTruck/WRO-FE-2026-Sin-Theta/models/CAD 3D Printed Parts/Third Plate.STL

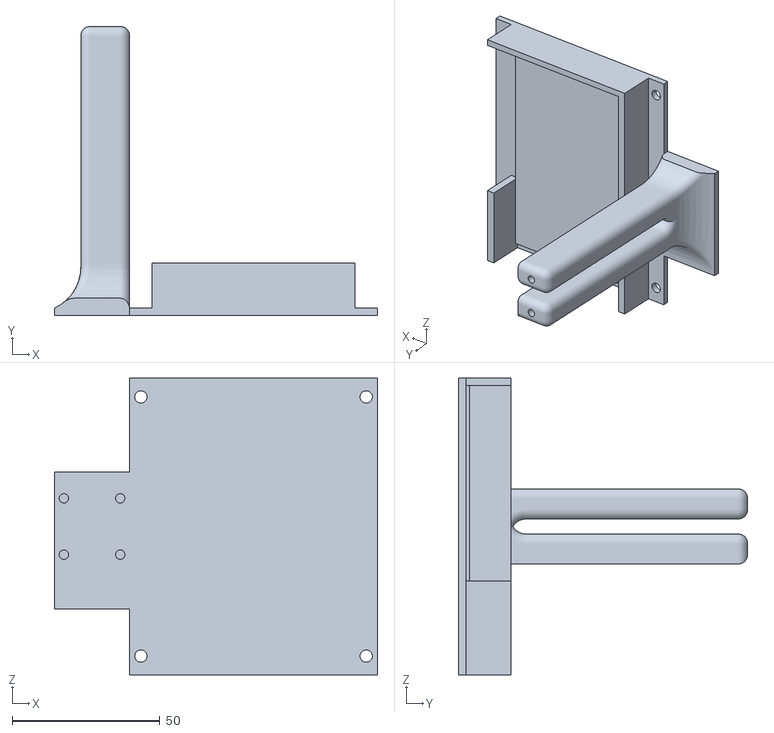
[picture p69: CAD file, 2026-08-23]
models/CAD 3D Printed Parts/Third Plate.STL
109.2 x 97.8 x 100.3
