JumpyTruck/WRO-FE-2026-Sin-Theta/models/CAD 3D Printed Parts/Second Plate.STL

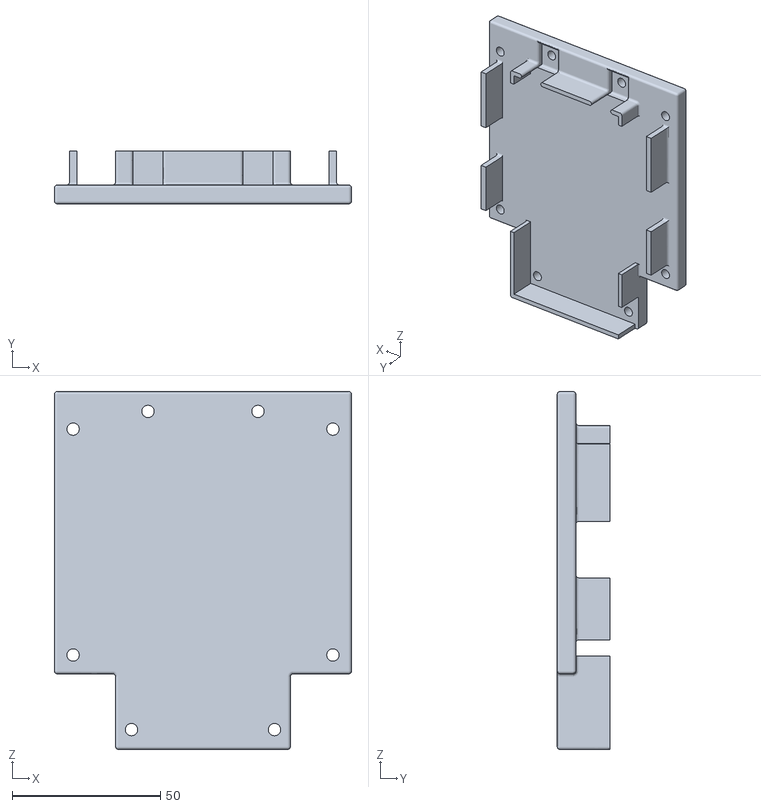
[picture p70: CAD file, 2026-08-23]
models/CAD 3D Printed Parts/Second Plate.STL
100.3 x 17.8 x 120.8
