JumpyTruck/WRO-FE-2026-Sin-Theta/models/CAD 3D Printed Parts/Steering T.STL

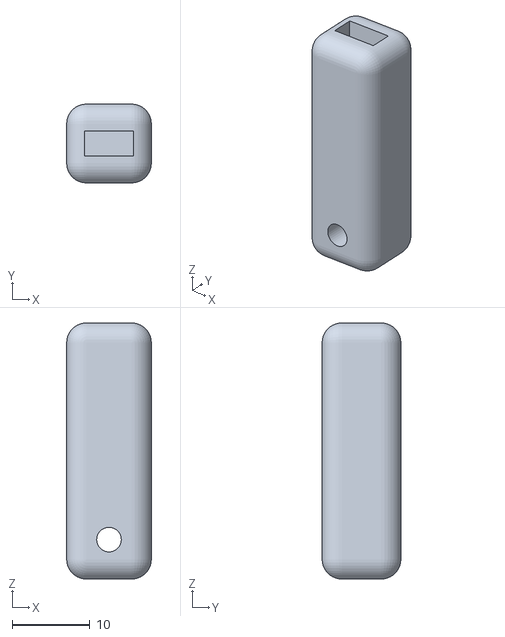
[picture p71: CAD file, 2026-08-23]
models/CAD 3D Printed Parts/Steering T.STL
10.9 x 10.2 x 33.0
