JumpyTruck/WRO-FE-2026-Sin-Theta/(list of files, cad)

Other CAD files:
models/CAD 3D Printed Parts/Servo Holder.STL
