JumpyTruck/WRO-FE-2026-Sin-Theta/models/CAD 3D Printed Parts/Inters Robot Files/Rear Axle Assembly.jpg

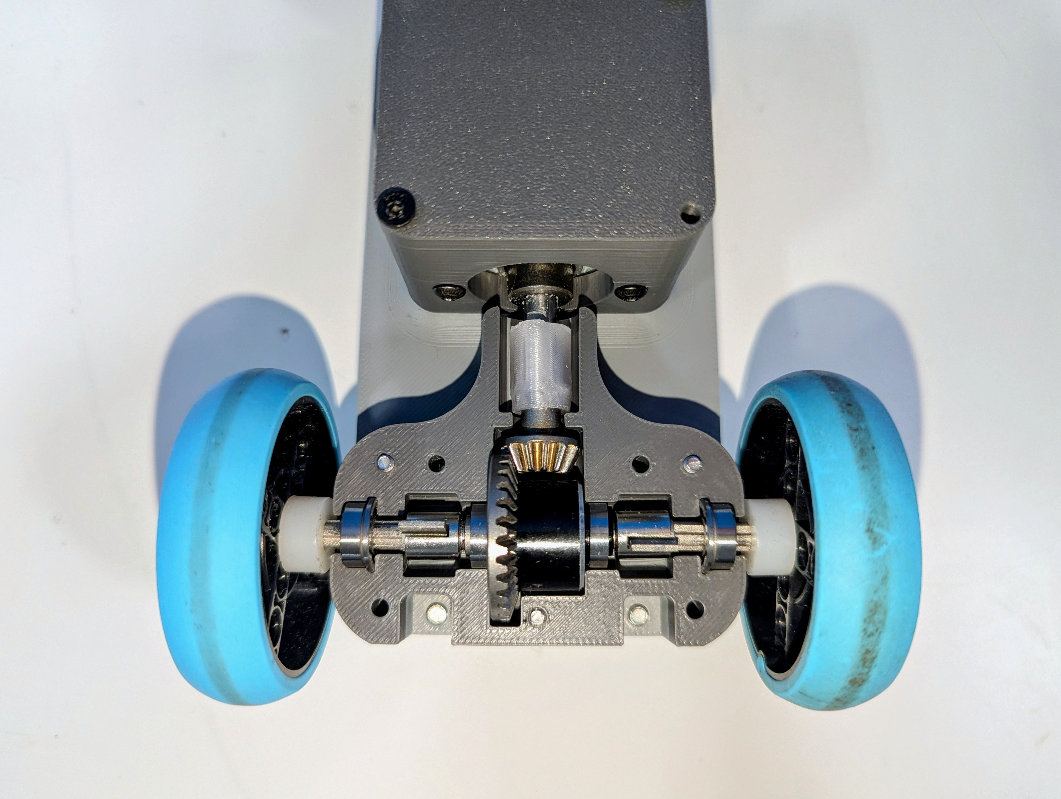
models/CAD 3D Printed Parts/Inters Robot Files/Rear Axle Assembly.jpg
