JumpyTruck/WRO-FE-2026-Sin-Theta/(commit log)

2026-07-24 Add motor control and obstacle avoidance functionality
    Implement motor control and obstacle avoidance logic using serial communication with ESP32. Includes threading for motor and servo commands, camera setup, and contour detection for navigation.
    This is the proper code.
    [OBS_FIN.py]
2026-07-30 Update print statement from 'Hello' to 'Goodbye'
2026-08-05 Update fmt.Println to print 'Goodbye World'
2026-08-07 Fix formatting for Servo Motor link in README
2026-08-07 Fix typo in project name from 'sinø' to 'sinθ'
2026-08-07 Revise README for clarity and detail enhancements
    Updated descriptions for clarity and added details about the Ackermann steering geometry and chassis design.
2026-08-07 Enhance README with updated steering design details
    Updated the README to include new designs for steering mechanisms and their benefits.
2026-08-07 Fix image link for simplified Ackermann steering
    Updated image link for final design in README.
2026-08-07 Fix image link in README for simplified Ackermann steering
    Updated image source link for final design section.
2026-08-07 Fix image link for simplified Ackermann steering
    Updated image source link in README for final design.
2026-08-07 Update README with new steering assembly details
    Added an image to illustrate the new steering assembly position and clarified the changes made to the chassis.
2026-08-07 Update README with second story plate design details
    Added details about the structural design process for the second story plate.
2026-08-09 Revise mechanical design documentation for clarity
    Updated the mechanical design documentation to reflect current design choices, including chassis, steering system, battery holder, and motor mount.
2026-08-20 Replace placeholder images with actual URLs
    Updated image references in the Camera-Based Detection section of the README.
2026-08-20 Update current draw formatting in README.md
2026-08-21 Remove motor torque calculation details
    Removed detailed motor torque calculation section to streamline the README.
2026-08-24 Fix link to CAD files in README
    Updated the link to the folder containing STL and PNG files.
2026-08-24 Update images in README for motor mount and camera assembly
2026-08-24 Adjust camera dimensions image size in README
    Updated the image size for the Camera Dimensions in the README.
2026-08-24 Adjust camera dimensions image width in README
    Updated image width for camera dimensions in README.
2026-08-24 Add Obstacle flowchart image to README
    Added image for the Obstacle flowchart in README.
2026-08-25 Add serial communication documentation
    Documented the communication protocol between Raspberry Pi and Arduino Nano, including command formats and implementation details.
2026-08-25 Enhance README with assembly and documentation sections
    Added detailed sections on robot assembly, PCB building, parts list, and engineering journal.
2026-08-25 Reorganize Raspberry Pi setup section in README
2026-08-31 Add 3D printed parts and update total cost
2026-08-31 Adjust pricing for 3D printed parts and total cost
    Updated the total cost and 3D printed parts price in the README.
2026-08-31 Update pricing and add new 3D printed parts
2026-09-01 Fix typo in README about sensor suite
    Corrected a typo in the README regarding the learning opportunity with the camera.
2026-09-02 Enhance README with testing and calibration details
    Added mechanical testing and validation section to README, detailing steering accuracy, chassis stability, and mechanical durability tests. Included camera calibration process and edge case handling strategies for improved performance.
2026-09-04 Rename Ackermann Steering Arm.STL to Ackermann Steering Knuckle.STL
2026-09-04 Rename Ackermann Steering Arm.png to Ackermann Steering Knuckle.png
2026-09-05 Refactor OpenChallenge.py with GPIO integration
    Refactor OpenChallenge.py to improve structure and add GPIO control for start button and status LED.
2026-09-05 Clean up comments in encoderISR function
    Removed comments explaining encoder ISR behavior.
2026-10-07 upload nationals arduino serial to nationals folder
2026-10-18 Revise camera placement details in README
    Updated camera placement rationale for clarity and detail.
2026-10-18 Enhance camera placement rationale in README
    Updated camera placement rationale with validation details.
2026-10-18 Revise images and descriptions in README.md
    Updated images and descriptions for the new Base Plate and Pi Holder on the International Robot Design.
2026-10-18 Revise rear axle section in README
    Updated descriptions and images for rear axle components, namely the chassis base plate, raspberry pi third plate, and rear axle assembly/casing.
2026-10-18 Correct bumper description to front wing
2026-10-18 Enhance README with motor decision calculations
    Added RPM and Torque calculations to support motor decision.
2026-10-19 Add speed and acceleration calculations to README
    Added mathematical descriptions for speed and acceleration capabilities based on motor RPM and torque, including tables and images.
2026-10-31 Update image for Full Rear Axle Assembly in README
    Replace original image with newer and more optimized design.
2026-10-31 Update speed measurement in chassis stability testing
2026-11-02 Expand README with manufacturing and material details
    Added detailed manufacturing and material specifications for 3D printed parts, including slicer settings and material selection rationale.
2026-11-02 Add summary tables for electrical architecture
    Added summary tables for system power budget and electrical pinout.
2026-11-10 Add STL Files for Final Inters Robot
2026-11-10 Add Exploded and Final Pictures of Final Inters CAD
2026-11-10 Add Images of CAD for Inters Robot
    Updated images and titles for exploded and full assembly views in the README.
2026-11-10 Create README.md for CAD 3D Printed Parts
    Add README for CAD 3D Printed Parts with project details.
2026-11-10 add nationals description for cad files
2026-11-10 update description for international cad files
2026-11-11 updated size of steering calculations
    Updated image size in steering calculations section of README.
2026-11-11 updated camera mount installed image
2026-11-11 removed software safeguards
    Updated LED status indicator description and removed software safeguards section for clarity.
